botblox/UbiSwitch-DaughterBoard-Designs/UbiSwitch DaughterBoard Mini /Source Kicad Files/BOM BB-UDM-A-1.xlsx

No | Ref | Value | Description | Manufacturer | Manufacturer Part Number | LCSC | Footprint | Quantity | Supplier 1 | Cost @10pcs | Cost @100pcs
1 | C1, C2, C3, C4, C5, C6, C7, C8, C11, C12, C13, C14, C15, C16, C17, C18, | 0.1uF | CAP CER 0.1UF 50V X7R 0402 | Murata Electronics | GRM155R71H104KE14J | C85858 | Kpk:C_0402_Small | 16 | LCSC | 0.0117 | 0.0117
2 | C9, C10, C19, C20, | 1nF/2kV | CAP CER 1000PF 2KV X7R 1206 | Yageo | CC1206KKX7RDBB102 | C23631 | Capacitor_SMD:C_1206_3216Metric | 4 | LCSC | 0.015 | 0.015
3 | C21, C22, | 0.01uF/1kV | CAP CER 10000PF 1000V X7R 1206 | YAGEO | CC1206KKX7RCBB103 | C107192 | Capacitor_SMD:C_1206_3216Metric | 2 | LCSC | 0.0151 | 0.0151
4 | D5, D6, D7, D8, | LED_Dual_ACAC | LED GREEN/RED CLEAR CHIP SMD | Lite-On Inc. | LTST-C295KGKRKT | C364568 | Kpk:LED_1608_ACAC | 4 | LCSC | 0.0462 | 0.0383
5 | D11, | 12V | DIODE ZENER 12V 300MW SOD323 | ON Semiconductor | MM3Z12VT1G | C236177 | Diode_SMD:D_SOD-323 | 1 | LCSC | 0.0564 | 0.0471
6 | D12, | SMAJ54CA | TVS DIODE 54V 87.1V DO214AC | Vishay Semiconductor Diodes Division | SMAJ54CA-E3/61 | C173507 | Diode_SMD:D_SMA | 1 | LCSC | 0.0595 | 0.0469
7 | D19, | GREEN | LED PURE GREEN 1608 SMD | Lite-On | LTST-C191KGKT | C125098 | LED_SMD:LED_0603_1608Metric | 1 | LCSC | 0.0211 | 0.0211
8 | J1, J16, J18, | Conn-4P | CONN HEADER SMD R/A 4POS 1MM | Molex | 5019530407 | C587888 | Connector_Molex:Molex_Pico-Clasp_202396-0407_1x04-1MP_P1.00mm_Horizontal | 3 | Mouser | 0.645 | 0.556
9 | J4, J5, J8, J9, | Conn-8P | CONN HEADER SMD R/A 8POS 1MM | Molex | 5015680807 | C587867 | Connector_Molex:Molex_Pico-Clasp_202396-0807_1x08-1MP_P1.00mm_Horizontal | 4 | LCSC | 0.3209 | 0.261
10 | J7, J13, | ERF8-030-05.0-S-DV-K-TR | CONN SOCKET 60POS SMD GOLD | Samtec Inc. | ERF8-030-05.0-S-DV-K-TR |  | Kpk:SAMTEC_ERF8-030-05.0-S-DV-K-TR | 2 | Mouser | 7.14 | 5.26
11 | J17, | Conn-6P | CONN HEADER SMD R/A 6POS 1MM | Molex | 5015680607 | C505000 | Connector_Molex:Molex_Pico-Clasp_202396-0607_1x06-1MP_P1.00mm_Horizontal | 1 | LCSC | 0.3334 | 0.2798
12 | L1, L2, L3, L4, L5, L6, L7, L8, L9, L10, L11, L12, L13, L14, L15, L16, | CMC-800R | CMC 300MA 2LN 800OHM SMD | CND-tek | CND-WCM0805M801-2 | C3020807 | Kpk:SRF2012A-801Y | 16 | LCSC | 0.0291 | 0.0291
13 | Q1, | SI2337DS | MOSFET P-CH 80V 2.2A SOT23-3 | Vishay Intertech | SI2337DS-T1-GE3 | C83155 | Package_TO_SOT_SMD:SOT-23 | 1 | LCSC | 0.5663 | 0.5122
14 | R1, R25, | 1M | RES SMD 1M OHM 5% 1/4W 1206 | Yageo | RC1206JR-071ML | C148194 | Resistor_SMD:R_1206_3216Metric | 2 | LCSC | 0.0034 | 0.0034
15 | R4, R5, | 150R | RES 150 OHM 1% 1/16W 0402 | Yageo | RC0402FR-07150RL | C138054 | Resistor_SMD:R_0402_1005Metric | 2 | LCSC | 0.001 | 0.001
16 | R7, | DNI |  |  | DNI |  | Resistor_SMD:R_0603_1608Metric_Pad0.98x0.95mm_HandSolder | 1
17 | R8, | 56K | RES 56K OHM 1% 1/16W 0402 | Yageo | RC0402FR-0756KL | C114756 | Resistor_SMD:R_0402_1005Metric | 1 | LCSC | 0.0006 | 0.0006
18 | R9, R10, R11, R12, R13, R14, R15, R16, R17, R18, R19, R20, R21, R22, R23, R24, | 75R | RES SMD 75 OHM 1% 1/16W 0402 | Yageo | RC0402FR-0775RL | C114757 | Resistor_SMD:R_0402_1005Metric | 16 | LCSC | 0.0008 | 0.0008
19 | R75, | 1K | RES SMD 1K OHM 1% 1/16W 0402 | Yageo | RC0402FR-071KL | C106235 | Resistor_SMD:R_0402_1005Metric | 1 | LCSC | 0.0007 | 0.0007
20 | T1, T2, T3, T4, T5, T6, T7, T8, T9, T10, T11, T12, T13, T14, T15, T16, | SM453229-381N7Y | XFRMR 1:1 350UH SUPER TINY SMD | Bourns Inc. | SM453229-381N7Y | C913239 | Kpk:SM453229-381N7Y_thinner | 16 | Ickey | 0.21 | 0.21
 |  |  |  |  |  |  |  |  |  | 22.846 | 18.4182
