botblox/UbiSwitch-DaughterBoard-Designs/UbiSwitch DaughterBoard/Source Kicad Files/BOM BB-UD1-A-1.xlsx

No | Ref | Value | Description | Manufacturer | Manufacturer Part Number | LCSC | Footprint | Quantity | Supplier 1 | Cost @10pcs | Cost @100pcs
1 | C1, C2, C3, C4, C5, C6, C7, C8, C11, C12, C13, C14, C15, C16, C17, C18, C22, C23, C24, C25, C26, C27, C28, C29, C32, C33, C34, C35, C36, C37, C38, C39, C42, C59, C60, C67, C68, C75, C76, | 0.1uF | CAP CER 0.1UF 50V X7R 0402 | Murata Electronics | GRM155R71H104KE14J | C85858 | Kpk:C_0402_Small | 39 | LCSC | 0.0117 | 0.0117
2 | C9, C10, C19, C20, C30, C31, C40, C41, | 1nF/2kV | CAP CER 1000PF 2KV X7R 1206 | Yageo | CC1206KKX7RDBB102 | C23631 | Capacitor_SMD:C_1206_3216Metric | 8 | LCSC | 0.015 | 0.015
3 | C21, | 0.01uF/1kV | CAP CER 10000PF 1000V X7R 1206 | YAGEO | CC1206KKX7RCBB103 | C107192 | Capacitor_SMD:C_1206_3216Metric | 1 | LCSC | 0.0151 | 0.0151
4 | C43, C44, | 2.2u | CAP CER 2.2UF 100V X7R 1206 | Samsung Electro-Mechanics | CL31B225KCHSNNE | C170101 | Capacitor_SMD:C_1206_3216Metric | 2 | LCSC | 0.0912 | 0.0912
5 | C45, C46, C47, C48, C49, C50, | 22uF | CAP CER 22UF 16V X6S 0805 | Samsung Electro-Mechanics | CL21X226MOYNNWE | C3039691 | Capacitor_SMD:C_0805_2012Metric | 6 | LCSC | 0.0881 | 0.0727
6 | C51, | 20p | CAP CER 20PF 50V C0G/NPO 0402 | Yageo | CC0402JRNPO9BN200 | C107000 | Kpk:C_0402_Small | 1 | LCSC | 0.024 | 0.011
7 | C52, | 1000pF | CAP CER 1000PF 50V X7R 0402 | Walsin Tech Corp | 0402B102K500CT | C301925 | Kpk:C_0402_Small | 1 | LCSC | 0.002 | 0.002
8 | C56, C57, C62, C63, C64, C65, C70, C71, C72, C73, C78, C79, | 47uF | CAP CER 47UF 10V X5R 0805 | TDK | C2012X5R1A476MTJ00E | C76636 | Capacitor_SMD:C_0805_2012Metric | 12 | LCSC | 0.1599 | 0.1599
9 | C58, C61, C66, C69, C74, C77, | 1uF | CAP CER 1UF 10V X6S 0402 | Murata Electronics | GRM155C81A105KA12D | C162161 | Kpk:C_0402_Small | 6 | LCSC | 0.0183 | 0.0183
10 | D1, D2, D3, D4, D5, D6, D7, D8, D9, D10, | LED_Dual_ACAC | LED GREEN/RED CLEAR CHIP SMD | Lite-On Inc. | LTST-C295KGKRKT | C364568 | Kpk:LED_1608_ACAC | 10 | LCSC | 0.0462 | 0.0383
11 | D11, | 12V | DIODE ZENER 12V 300MW SOD323 | ON Semiconductor | MM3Z12VT1G | C236177 | Diode_SMD:D_SOD-323 | 1 | LCSC | 0.0564 | 0.0471
12 | D12, | SMAJ54CA | TVS DIODE 54V 87.1V DO214AC | Vishay Semiconductor Diodes Division | SMAJ54CA-E3/61 | C173507 | Diode_SMD:D_SMA | 1 | LCSC | 0.0595 | 0.0469
13 | D13, | 4.7V | DIODE ZENER 4.7V 550MW SOD323F | Nexperia | BZX84J-C4V7,115 | C551023 | Kpk:D_SOD-323F | 1 | LCSC | 0.221 | 0.117
14 | D14, D16, D17, D18, D19, | GREEN | LED PURE GREEN 1608 SMD | Lite-On | LTST-C191KGKT | C125098 | LED_SMD:LED_0603_1608Metric | 5 | LCSC | 0.0211 | 0.0211
15 | D15, | 100V 60A pk | DIODE SCHOTTKY 100V 1.7A DO214AC | Vishay General Semiconductor | VSSA310S-E3/61T | C468173 | Diode_SMD:D_SMA | 1 | Mouser | 0.381 | 0.26
16 | J1, J16, J18, | Conn-4P | CONN HEADER SMD 4POS 1MM | Molex | 5013310407 | C505339 | Kpk:Molex_Pico-Clasp_501331-0407_1x04-1MP_P1.00mm_Vertical_PicoBlade_Alternate | 3 | LCSC | 0.3077 | 0.2502
17 | J2, J6, J10, | SFP+ | CONN SFP+ RCPT 20POS SLD R/A SMD | Molex | 744410001 | C277615 | Kpk:Connector_SFP | 3 | LCSC | 0.5378 | 0.3771
18 | J3, | Conn_Coaxial | CONN UMC RCPT STR 50 OHM SMD | TE Connectivity AMP Connectors | 1909763-1 | C392444 | Connector_Coaxial:U.FL_Hirose_U.FL-R-SMT-1_Vertical | 1 | LCSC | 0.2335 | 0.1854
19 | J4, J5, J8, J9, J11, J12, J14, J15, | Conn-8P | CONN HEADER SMD 8POS 1MM | Molex | 5013310807 | C505340 | Kpk:Molex_Pico-Clasp_501331-0807_1x08-1MP_P1.00mm_Vertical_PicoBlade_Alternate | 8 | Digi-Key | 0.727 | 0.606
20 | J7, J13, | ERF8-030-05.0-S-DV-K-TR | CONN SOCKET 60POS SMD GOLD | Samtec Inc. | ERF8-030-05.0-S-DV-K-TR |  | Kpk:SAMTEC_ERF8-030-05.0-S-DV-K-TR | 2 | Mouser | 7.14 | 5.26
21 | J17, | Conn-9P | CONN HEADER SMD 9POS 1MM | Molex | 5013310907 | C114116 | Kpk:Molex_Pico-Clasp_501331-0907_1x09-1MP_P1.00mm_Vertical_PicoBlade_Alternate | 1 | LCSC | 0.2843 | 0.2261
22 | L1, L2, L3, L4, L5, L6, L7, L8, L9, L10, L11, L12, L13, L14, L15, L16, L17, L18, L19, L20, L21, L22, L23, L24, L25, L26, L27, L28, L29, L30, L31, L32, | CMC-800R | CMC 300MA 2LN 800OHM SMD | CND-tek | CND-WCM0805M801-2 | C3020807 | Kpk:SRF2012A-801Y | 32 | LCSC | 0.0291 | 0.0291
23 | L33, | 10uH 4A | FIXED IND 10UH 4A 68MOHM SMD | AVX Corporation | LMLP07A7M100DTAS |  | Kpk:L_7.3x6.6_H3 | 1 | Mouser | 0.335 | 0.281
24 | L34, L35, L36, L37, L38, L39, | 3.3uH | FIXED IND 3.3UH 1.8A 135MOHM SMD | Murata Electronics | DFE252012F-3R3M=P2 | C2041573 | Inductor_SMD:L_1008_2520Metric | 6 | LCSC | 0.1158 | 0.0942
25 | N1, | SFP+_CAGE | 1X3 ZSFP+ CAGE EON W/O BELLY GAS | CZT | 10731013W008 |  | Kpk:Connector_SFP_and_Cage_10731013W008_CZT | 1 | Alibaba | 2 | 1.55
26 | Q1, | RD3P130SPTL1 | MOSFET P-CH 100V 13A TO252 | Rohm Semiconductor | RD3P130SPTL1 | C509778 | Kpk:RD3P130SPTL1 | 1 | LCSC | 1.4535 | 1.0243
27 | R1, R2, R3, R4, R5, | 150R | RES 150 OHM 1% 1/16W 0402 | Yageo | RC0402FR-07150RL | C138054 | Resistor_SMD:R_0402_1005Metric | 5 | LCSC | 0.001 | 0.001
28 | R6, R43, R49, R74, R75, | 1K | RES SMD 1K OHM 1% 1/16W 0402 | Yageo | RC0402FR-071KL | C106235 | Resistor_SMD:R_0402_1005Metric | 5 | LCSC | 0.0007 | 0.0007
29 | R7, | DNI |  |  | DNI |  | Resistor_SMD:R_0805_2012Metric_Pad1.20x1.40mm_HandSolder | 1
30 | R8, | 56K | RES 56K OHM 1% 1/16W 0402 | Yageo | RC0402FR-0756KL | C114756 | Resistor_SMD:R_0402_1005Metric | 1 | LCSC | 0.0006 | 0.0006
31 | R9, R10, R11, R12, R13, R14, R15, R16, R17, R18, R19, R20, R21, R22, R23, R24, R26, R27, R28, R29, R30, R31, R32, R33, R34, R35, R36, R37, R38, R39, R40, R41, | 75R | RES SMD 75 OHM 1% 1/16W 0402 | Yageo | RC0402FR-0775RL | C114757 | Resistor_SMD:R_0402_1005Metric | 32 | LCSC | 0.0008 | 0.0008
32 | R25, | 1M | RES SMD 1M OHM 5% 1/4W 1206 | Yageo | RC1206JR-071ML | C148194 | Resistor_SMD:R_1206_3216Metric | 1 | LCSC | 0.0034 | 0.0034
33 | R42, | 220K | RES SMD 220K OHM 1% 1/16W 0402 | Yageo | RC0402FR-07220KL | C138030 | Resistor_SMD:R_0402_1005Metric | 1 | LCSC | 0.0014 | 0.0014
34 | R44, | 31.6K | RES 31.6K OHM 1% 1/16W 0402 | Yageo | RC0402FR-0731K6L | C276265 | Resistor_SMD:R_0402_1005Metric | 1 | LCSC | 0.0007 | 0.0007
35 | R45, | 23.7k | RES SMD 23.7K OHM 1% 1/16W 0402 | Yageo | RC0402FR-0723K7L | C327362 | Resistor_SMD:R_0402_1005Metric | 1 | LCSC | 0.017 | 0.006
36 | R46, | 86.6K | RES SMD 86.6K OHM 1% 1/16W 0402 | Yageo | RC0402FR-0786K6L | C477807 | Resistor_SMD:R_0402_1005Metric | 1 | LCSC | 0.0015 | 0.0015
37 | R47, | 162k | RES SMD 162K OHM 1% 1/16W 0402 | Yageo | RC0402FR-07162KL | C185462 | Resistor_SMD:R_0402_1005Metric | 1 | LCSC | 0.017 | 0.006
38 | R48, | 10K | RES SMD 10K OHM 1% 1/16W 0402 | Yageo | RC0402FR-0710KL | C60490 | Resistor_SMD:R_0402_1005Metric | 1 | LCSC | 0.0006 | 0.0006
39 | R50, R51, R52, R53, R54, R57, R58, R59, R60, R61, R62, R65, R66, R67, R68, R69, R70, R73, | 4.99K | RES 4.99K OHM 1% 1/16W 0402 | Yageo | RC0402FR-074K99L | C137965 | Resistor_SMD:R_0402_1005Metric | 18 | LCSC | 0.0007 | 0.0007
40 | R55, R63, R71, | 100R | RES 100 OHM 1% 1/16W 0402 | Yageo | RC0402FR-07100RL | C106232 | Resistor_SMD:R_0402_1005Metric | 3 | LCSC | 0.0007 | 0.0007
41 | R56, R64, R72, | 1K_DNI |  |  | DNI |  | Resistor_SMD:R_0402_1005Metric | 3
42 | T1, T2, T3, T4, T5, T6, T7, T8, T9, T10, T11, T12, T13, T14, T15, T16, T17, T18, T19, T20, T21, T22, T23, T24, T25, T26, T27, T28, T29, T30, T31, T32, | SM453229-381N7Y | XFRMR 1:1 350UH SUPER TINY SMD | Bourns Inc. | SM453229-381N7Y | C913239 | Kpk:SM453229-381N7Y_thinner | 32 | Ickey | 0.21 | 0.21
43 | U1, | TPS54360B | IC REG BCK SPLIT RAIL ADJ 8SOPWR | Texas Instruments | TPS54360BDDAR | C524806 | Package_SO:TI_SO-PowerPAD-8_ThermalVias | 1 | Texas Instruments | 1.5655 | 1.2823
