botblox/UbiSwitch-DaughterBoard-Designs/UbiSwitch DaughterBoard/Schematic UbiSwitch DaugterBoard.pdf

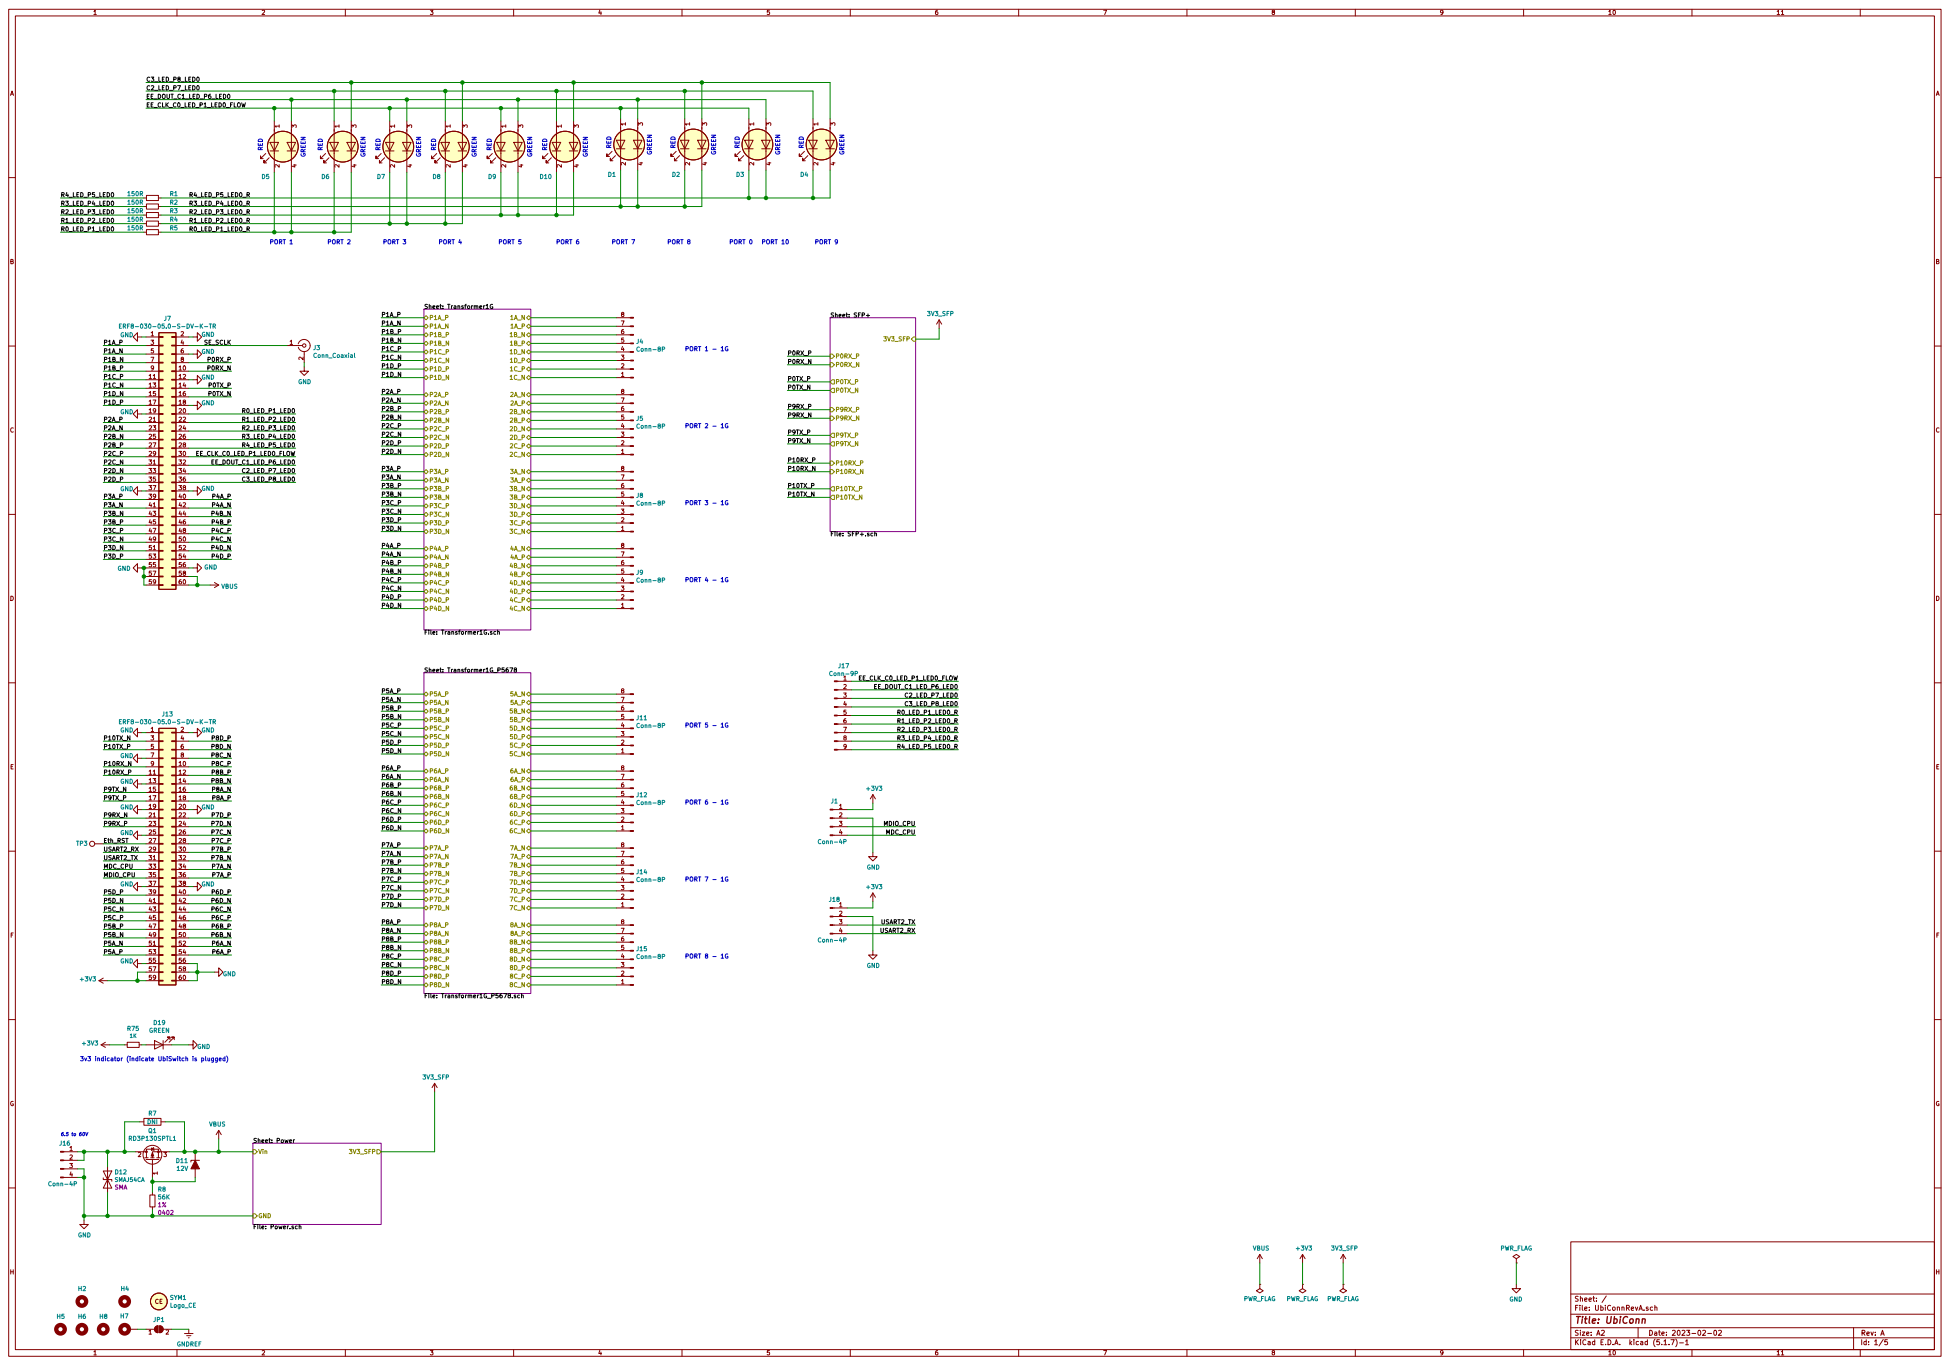
[picture p1: page 1]

3V3_SFP
Sheet: SFP+ File: SFP+.sch

3v3 indicator (indicate UbiSwitch is plugged)

File: UbiConnRevA.sch Sheet: / Sheet: Power File: Power.sch Vin GND

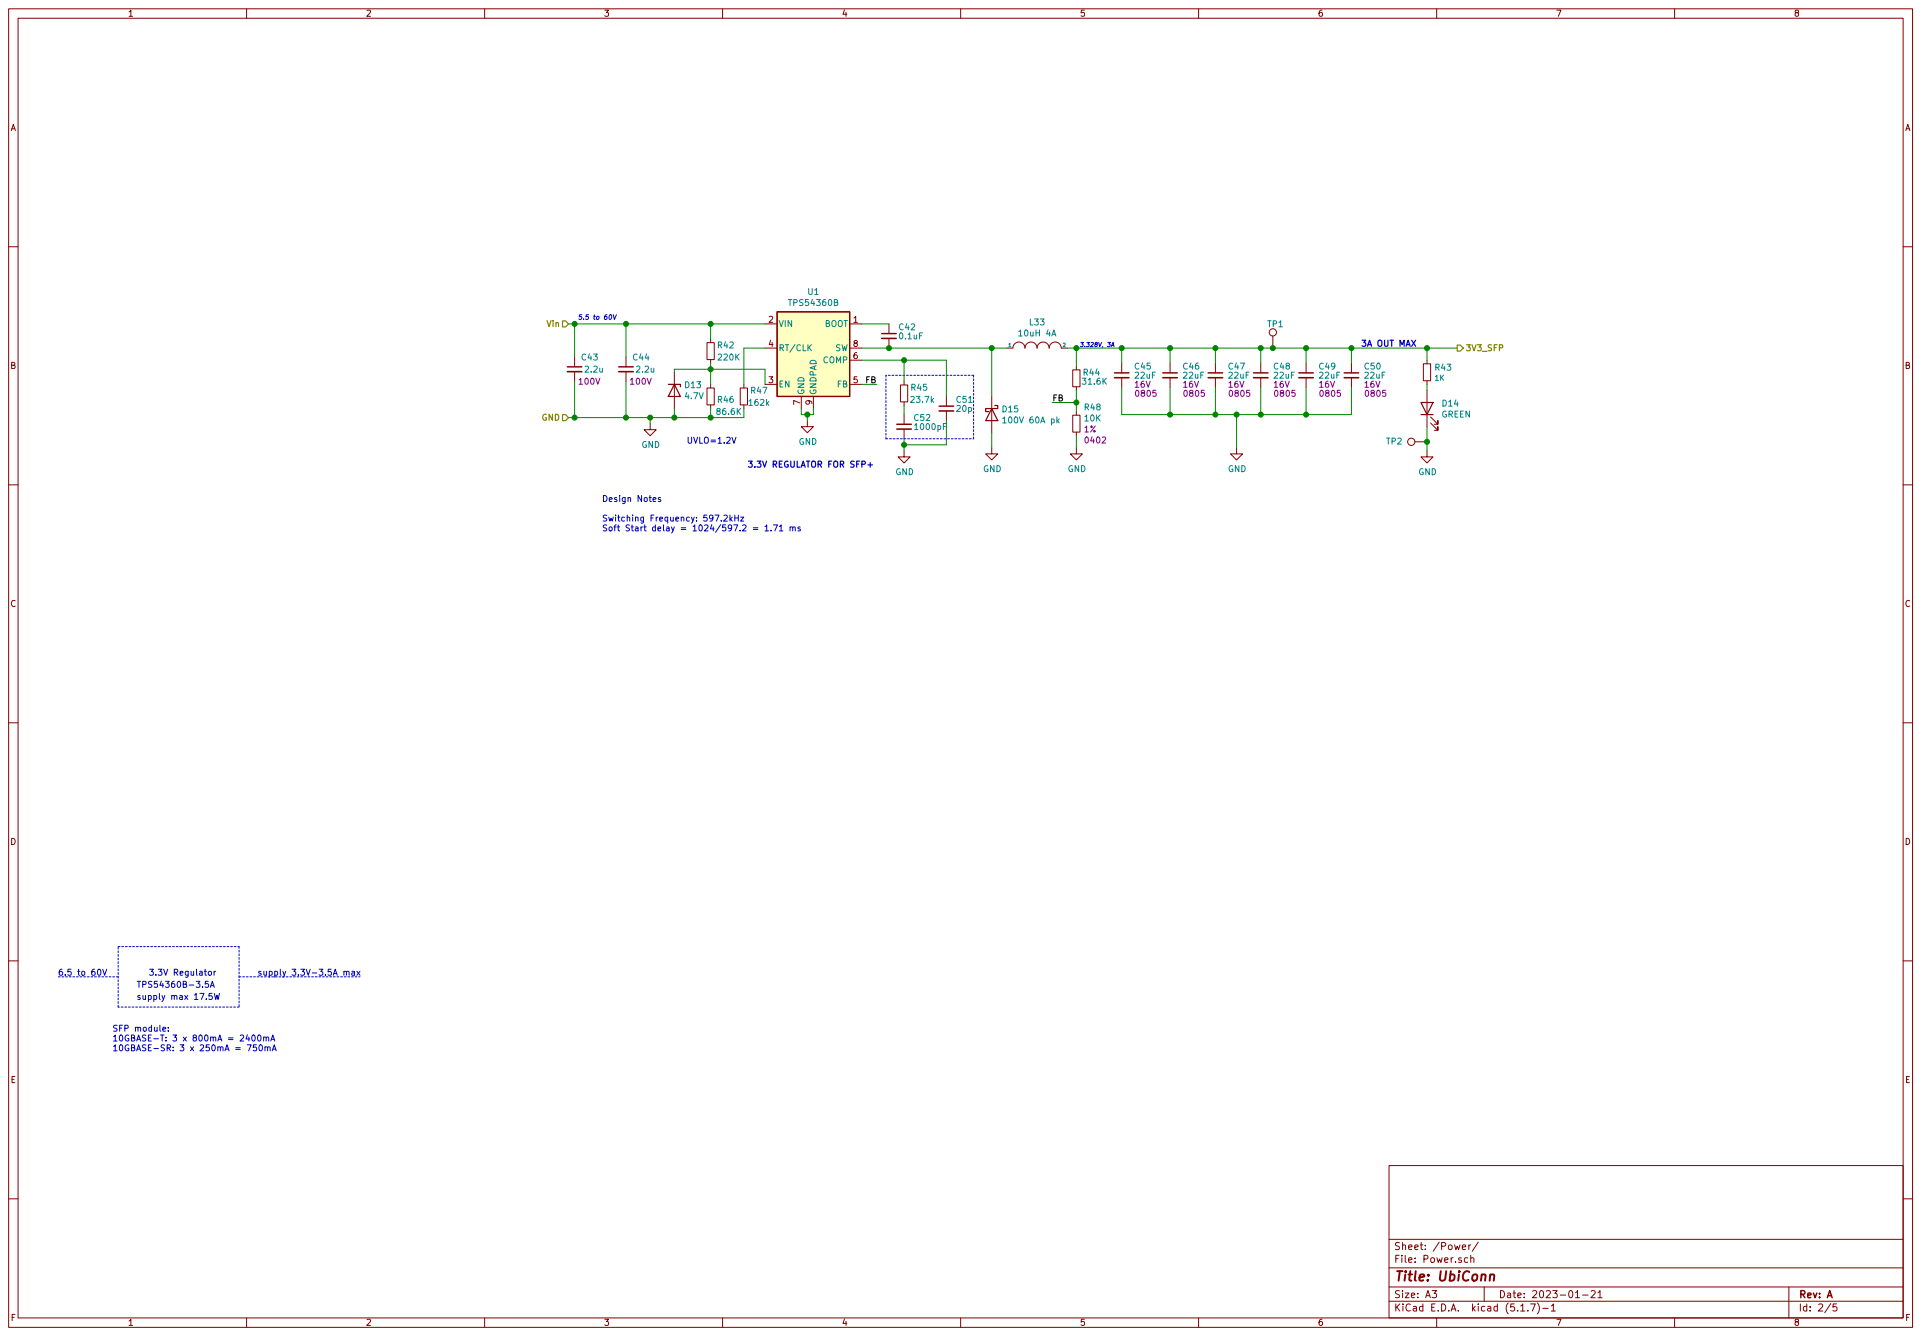
[picture p2: page 2]

Soft Start delay = 1024/597.2 = 1.71 ms UVLO=1.2V

File: Power.sch Sheet: /Power/
Id: 2/5 Title: UbiConn

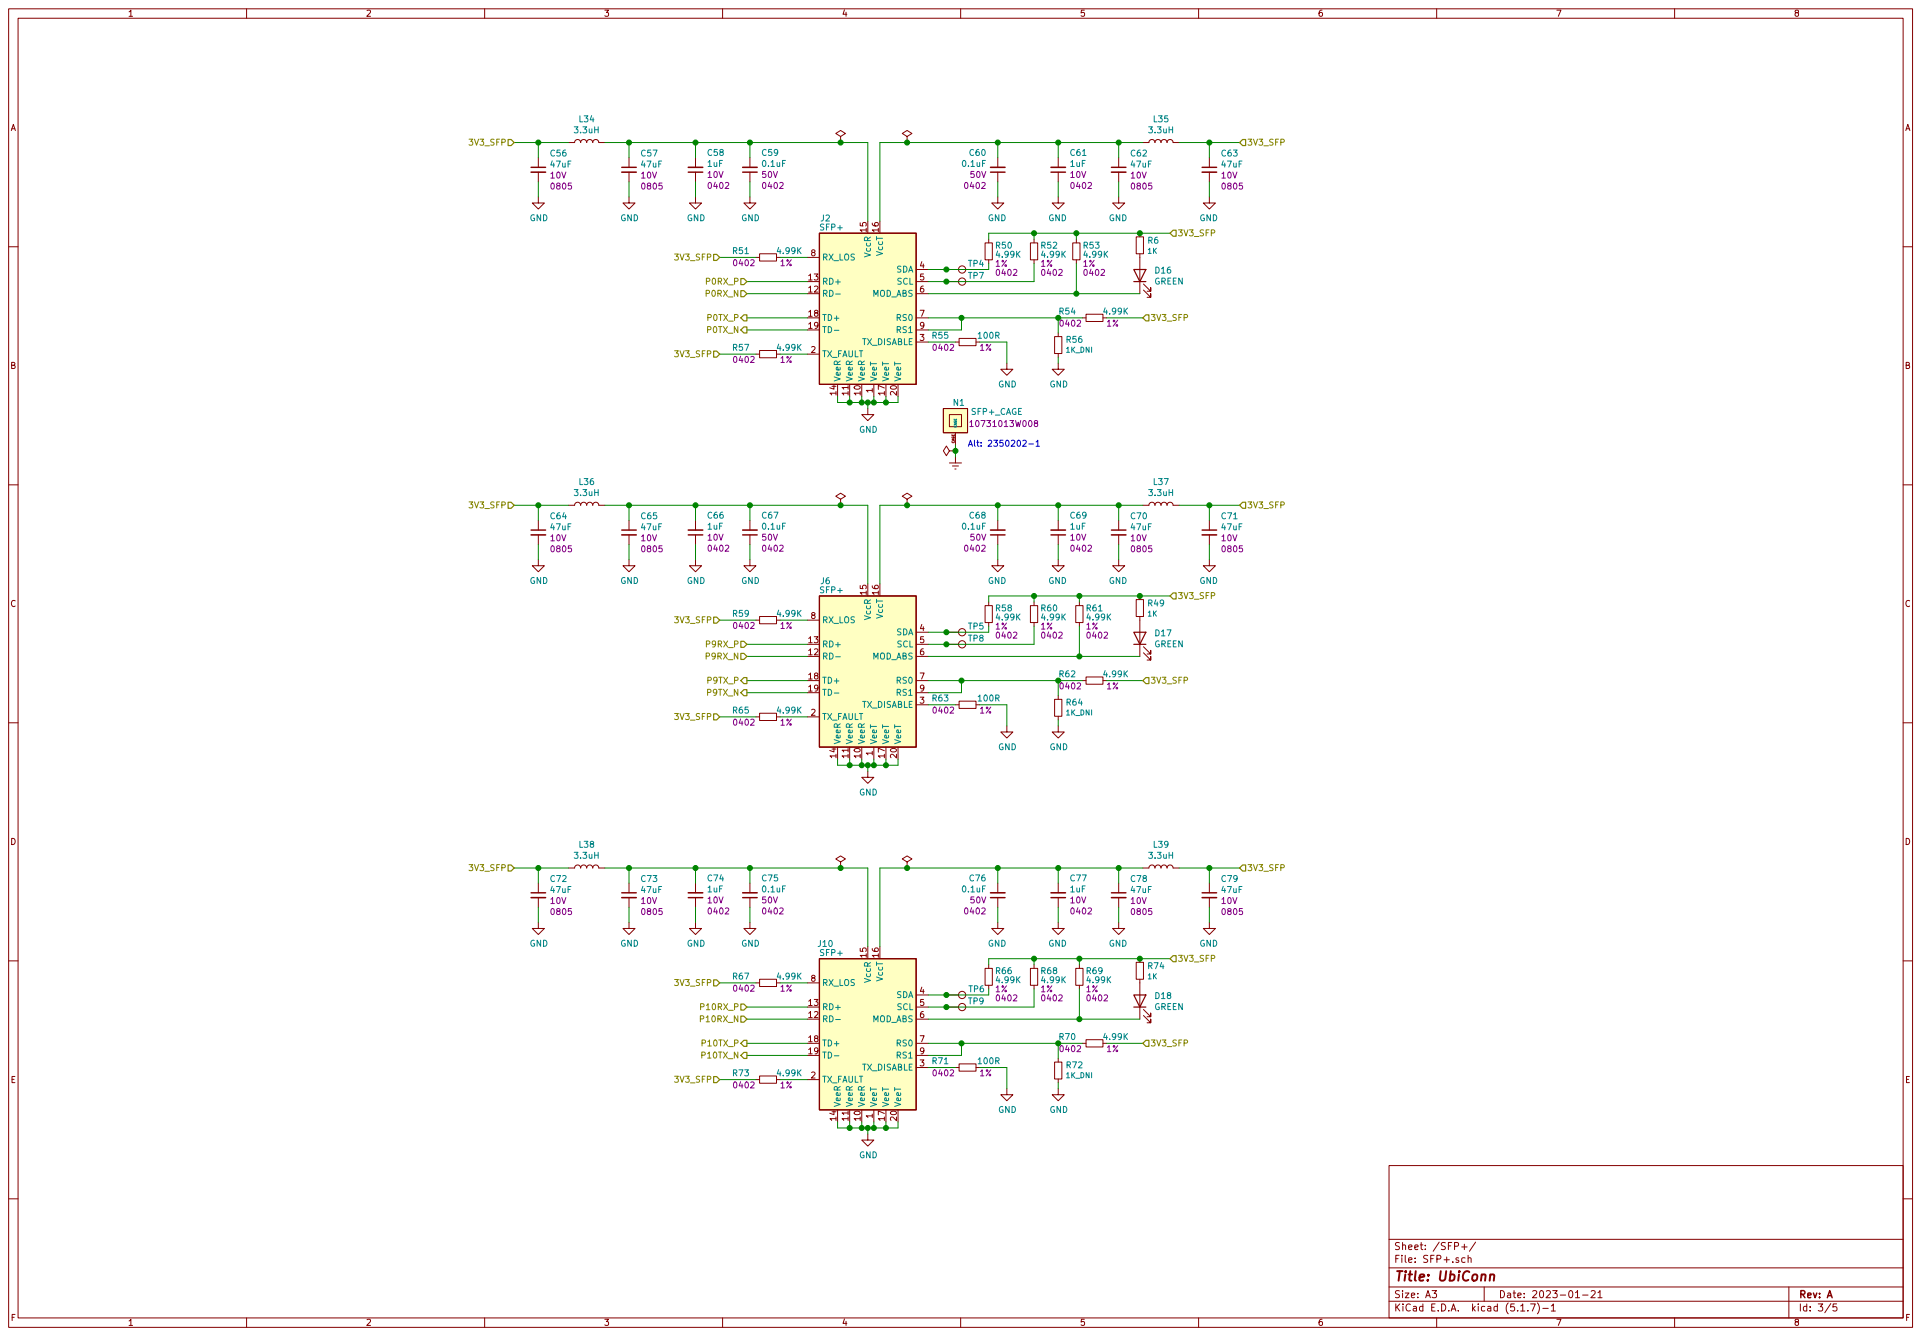
[picture p3: page 3]

File: SFP+.sch Sheet: /SFP+/
Id: 3/5 Title: UbiConn

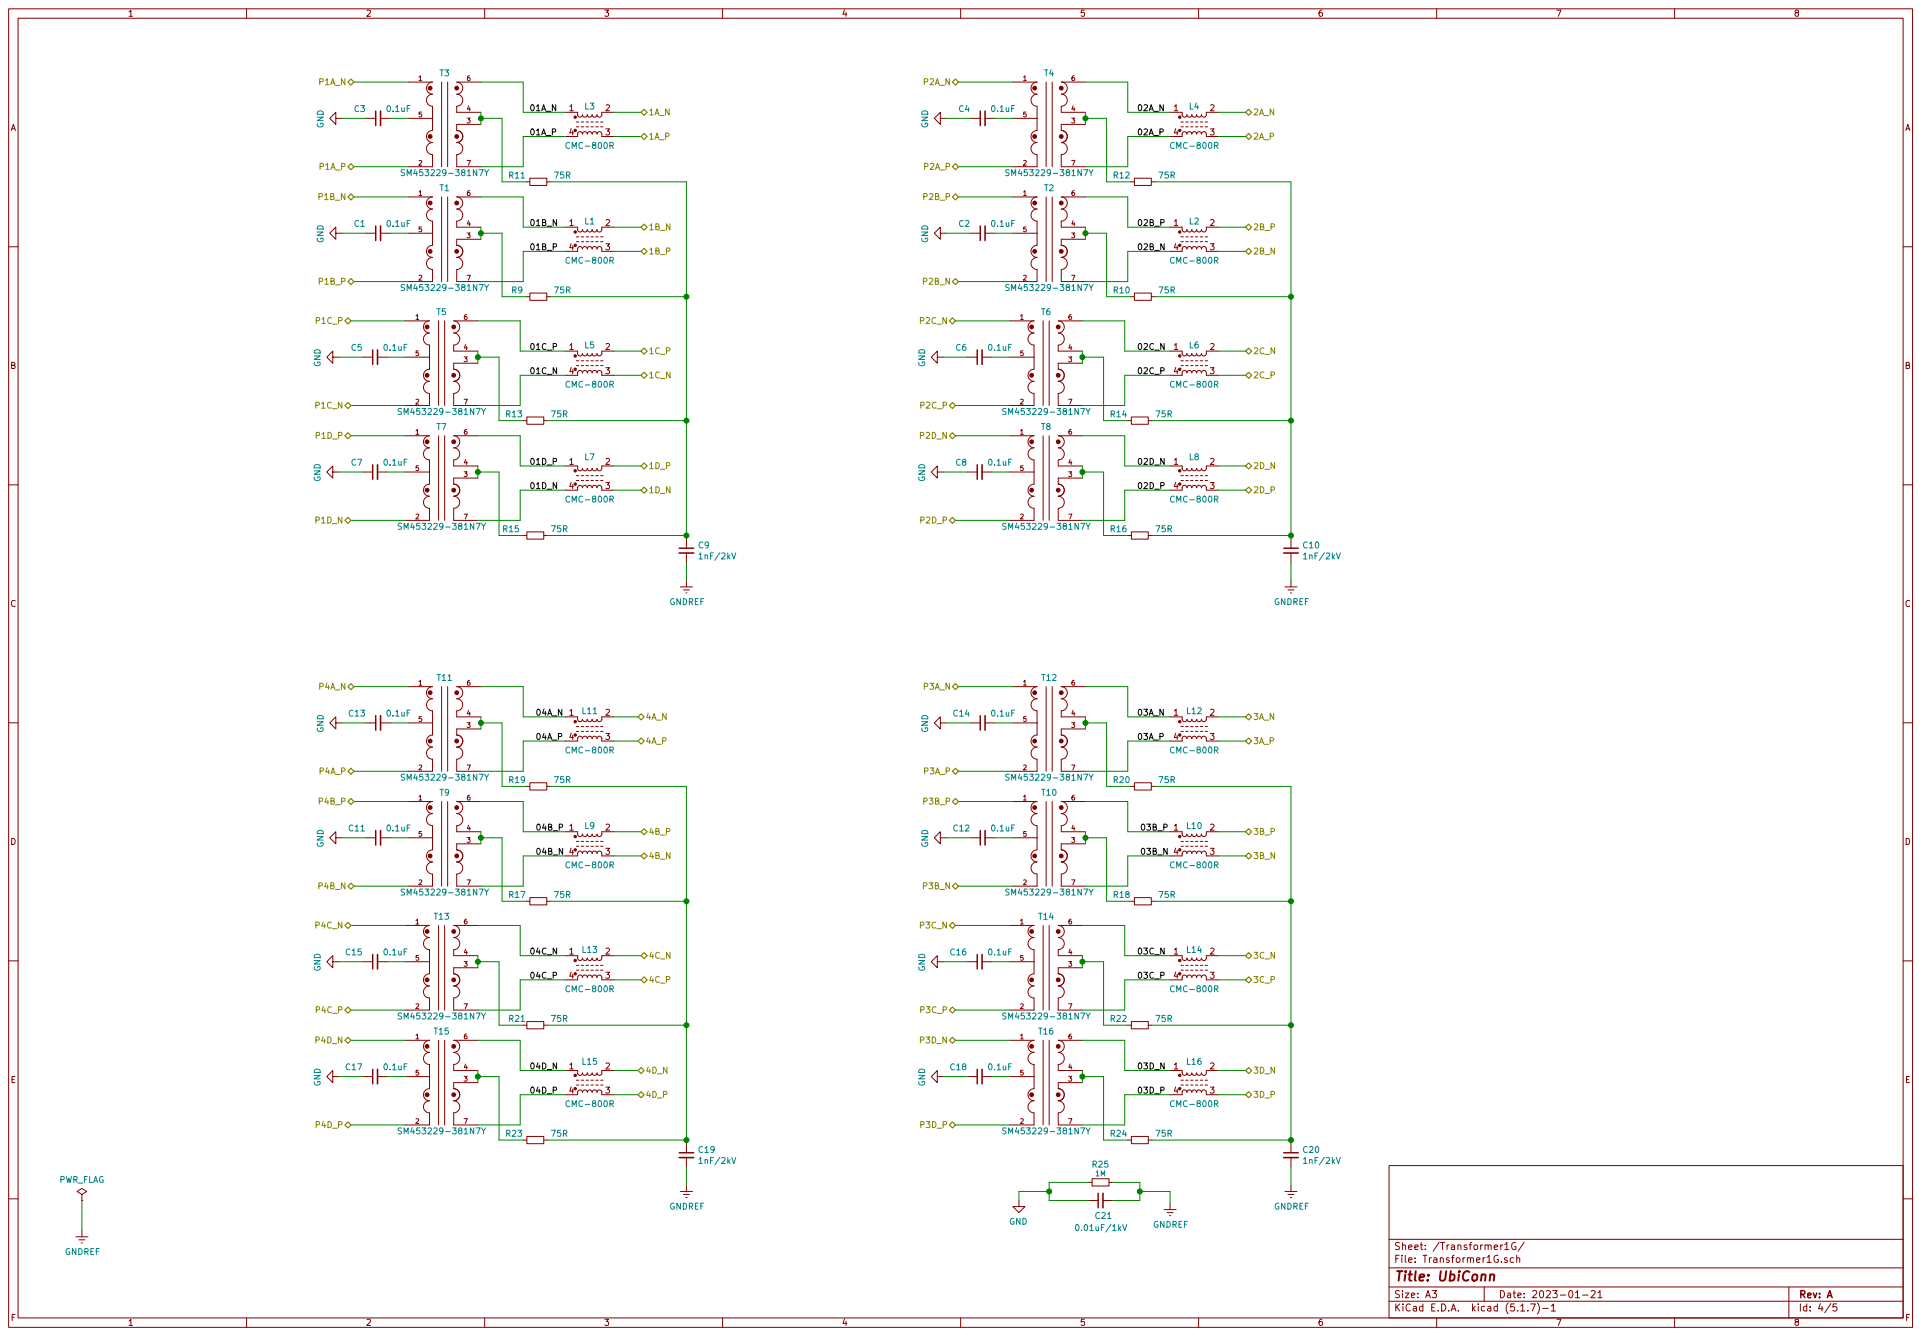
[picture p4: page 4]

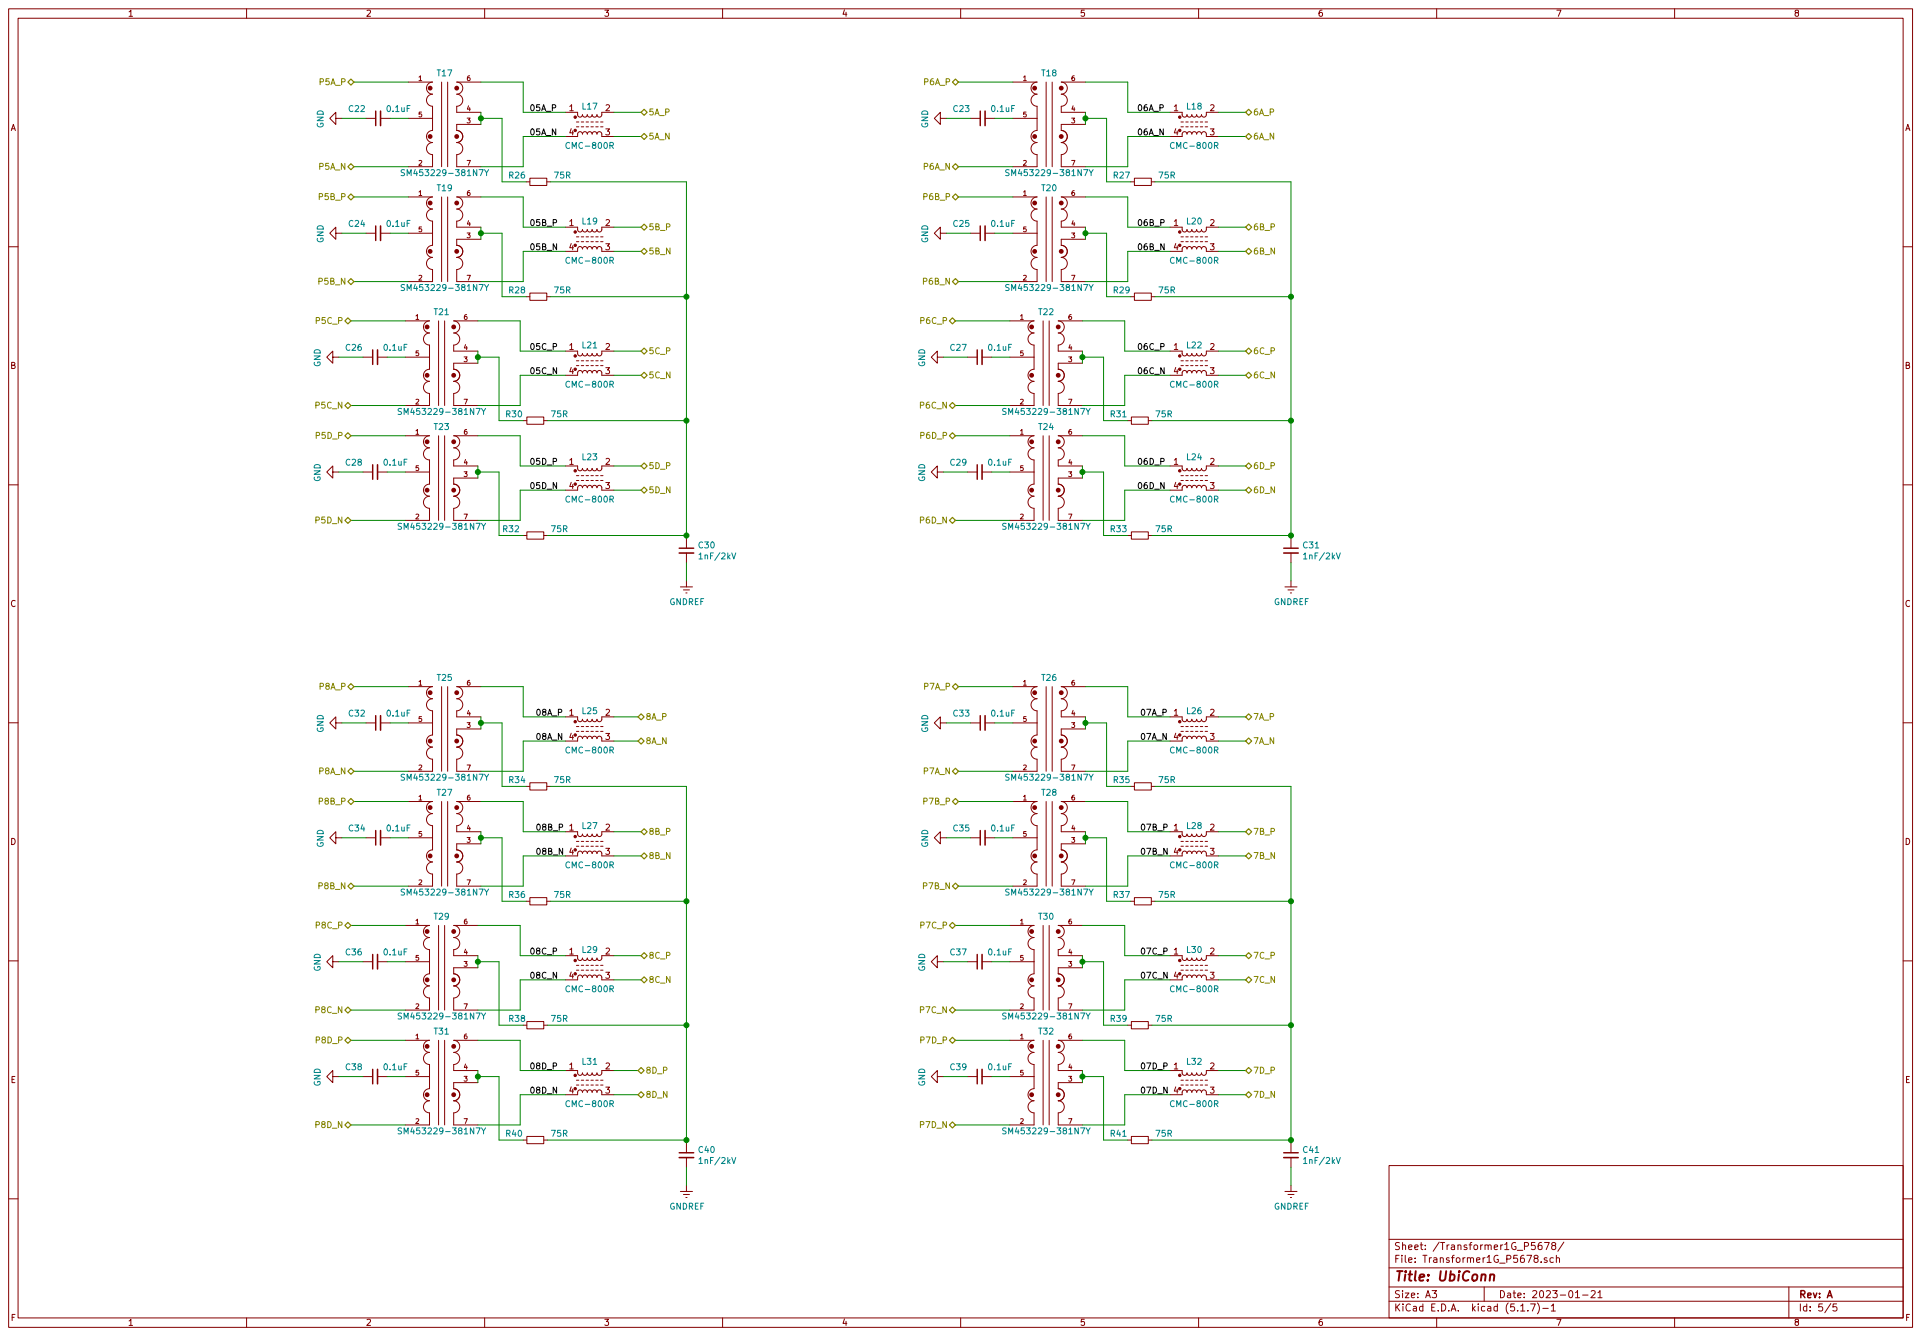
[picture p5: page 5]

L32 CMC-800R GND GND GND GND
