botblox/UbiSwitch-DaughterBoard-Designs/UbiSwitch DaughterBoard Mini /BB-UDM-A-1 Schematic.pdf

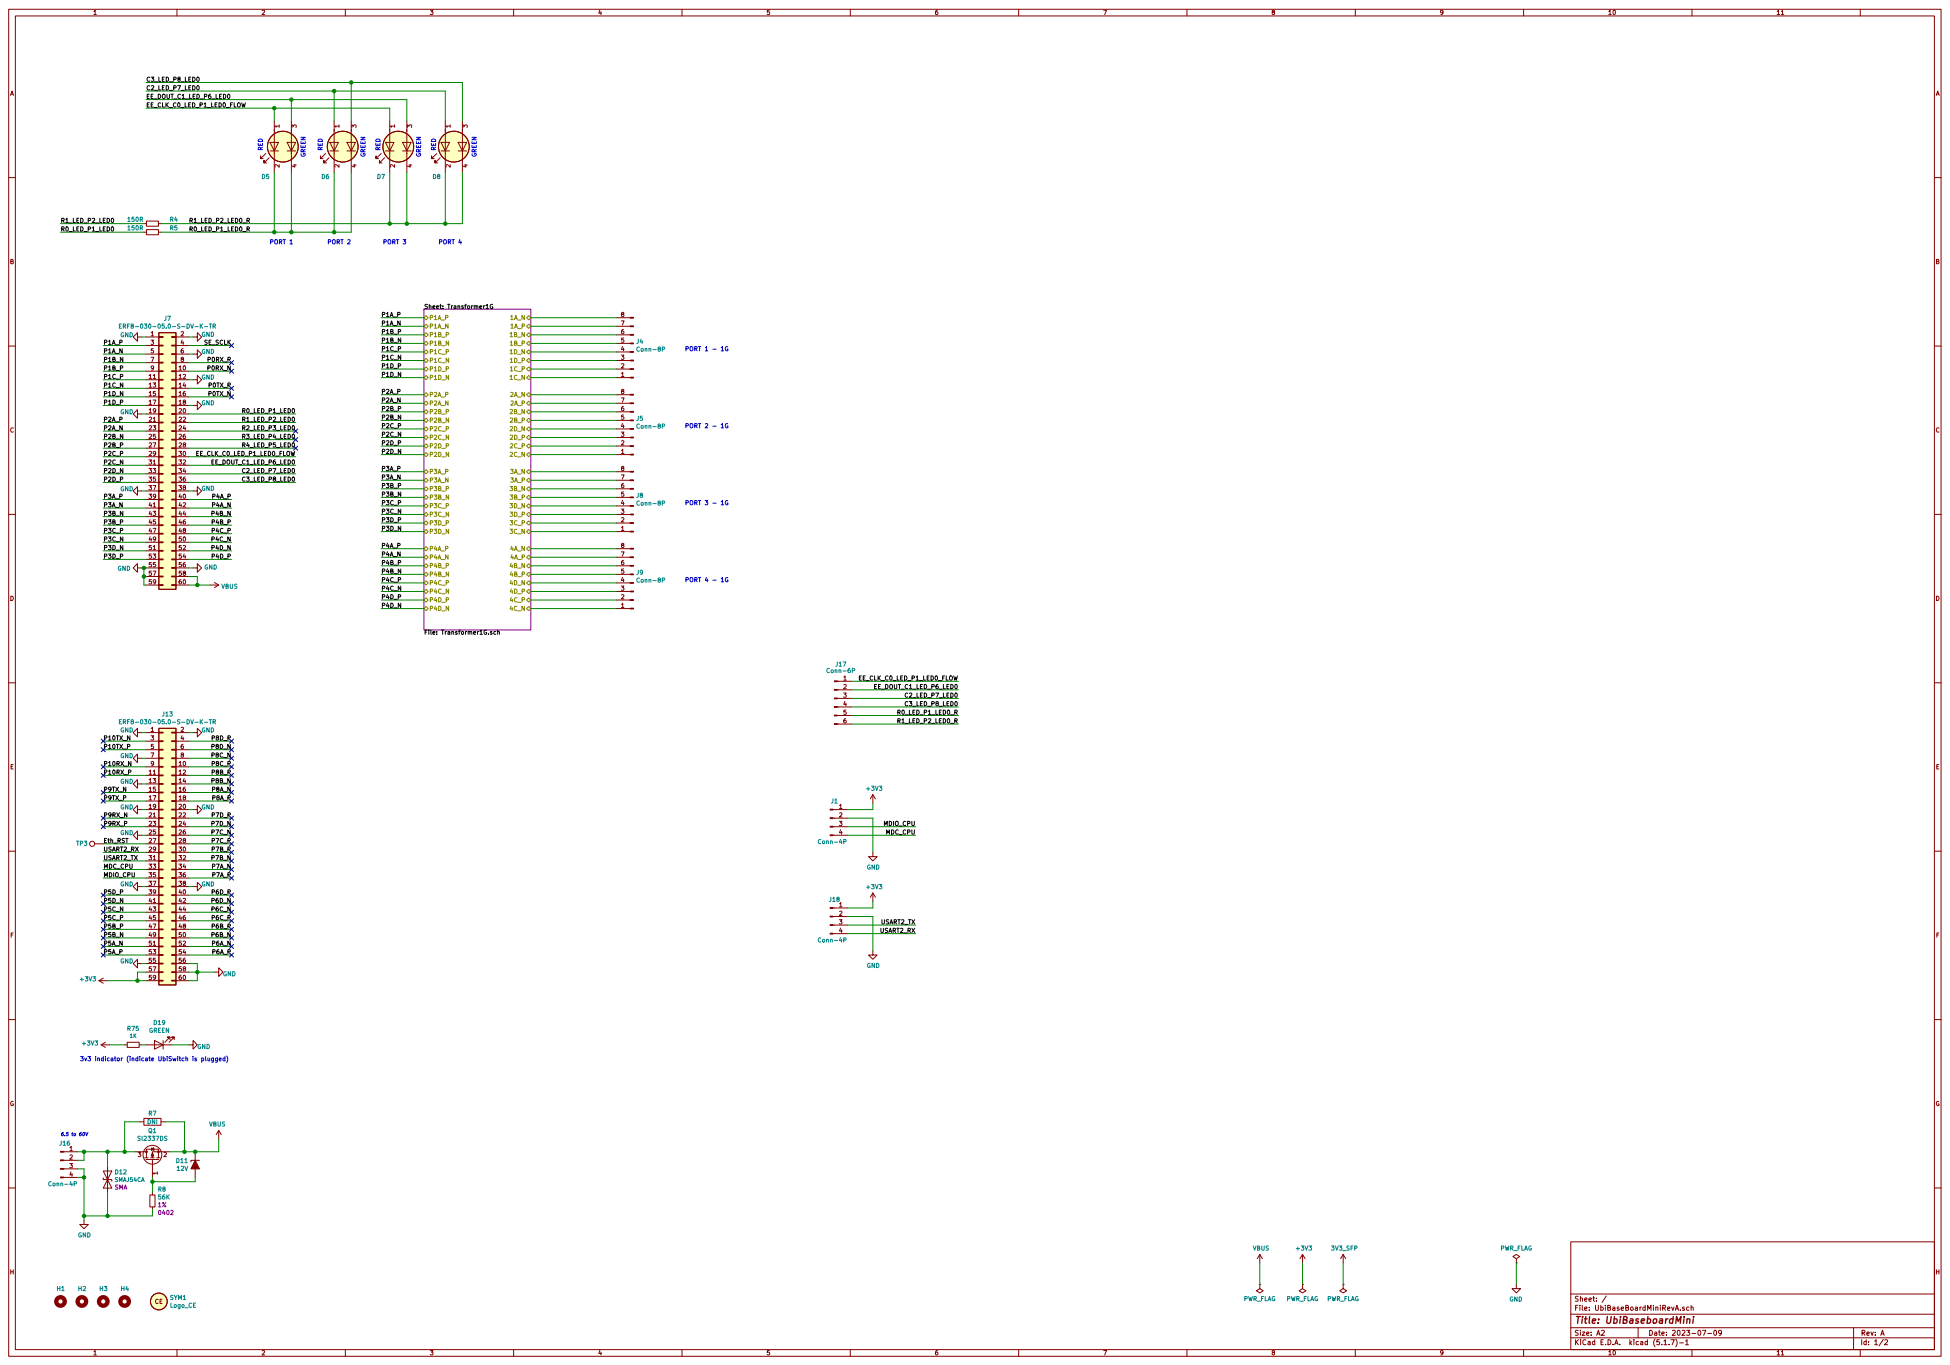
[picture p6: page 1]

3v3 indicator (indicate UbiSwitch is plugged)

Id: 1/2 Title: UbiBaseboardMini File: UbiBaseBoardMiniRevA.sch Sheet: /

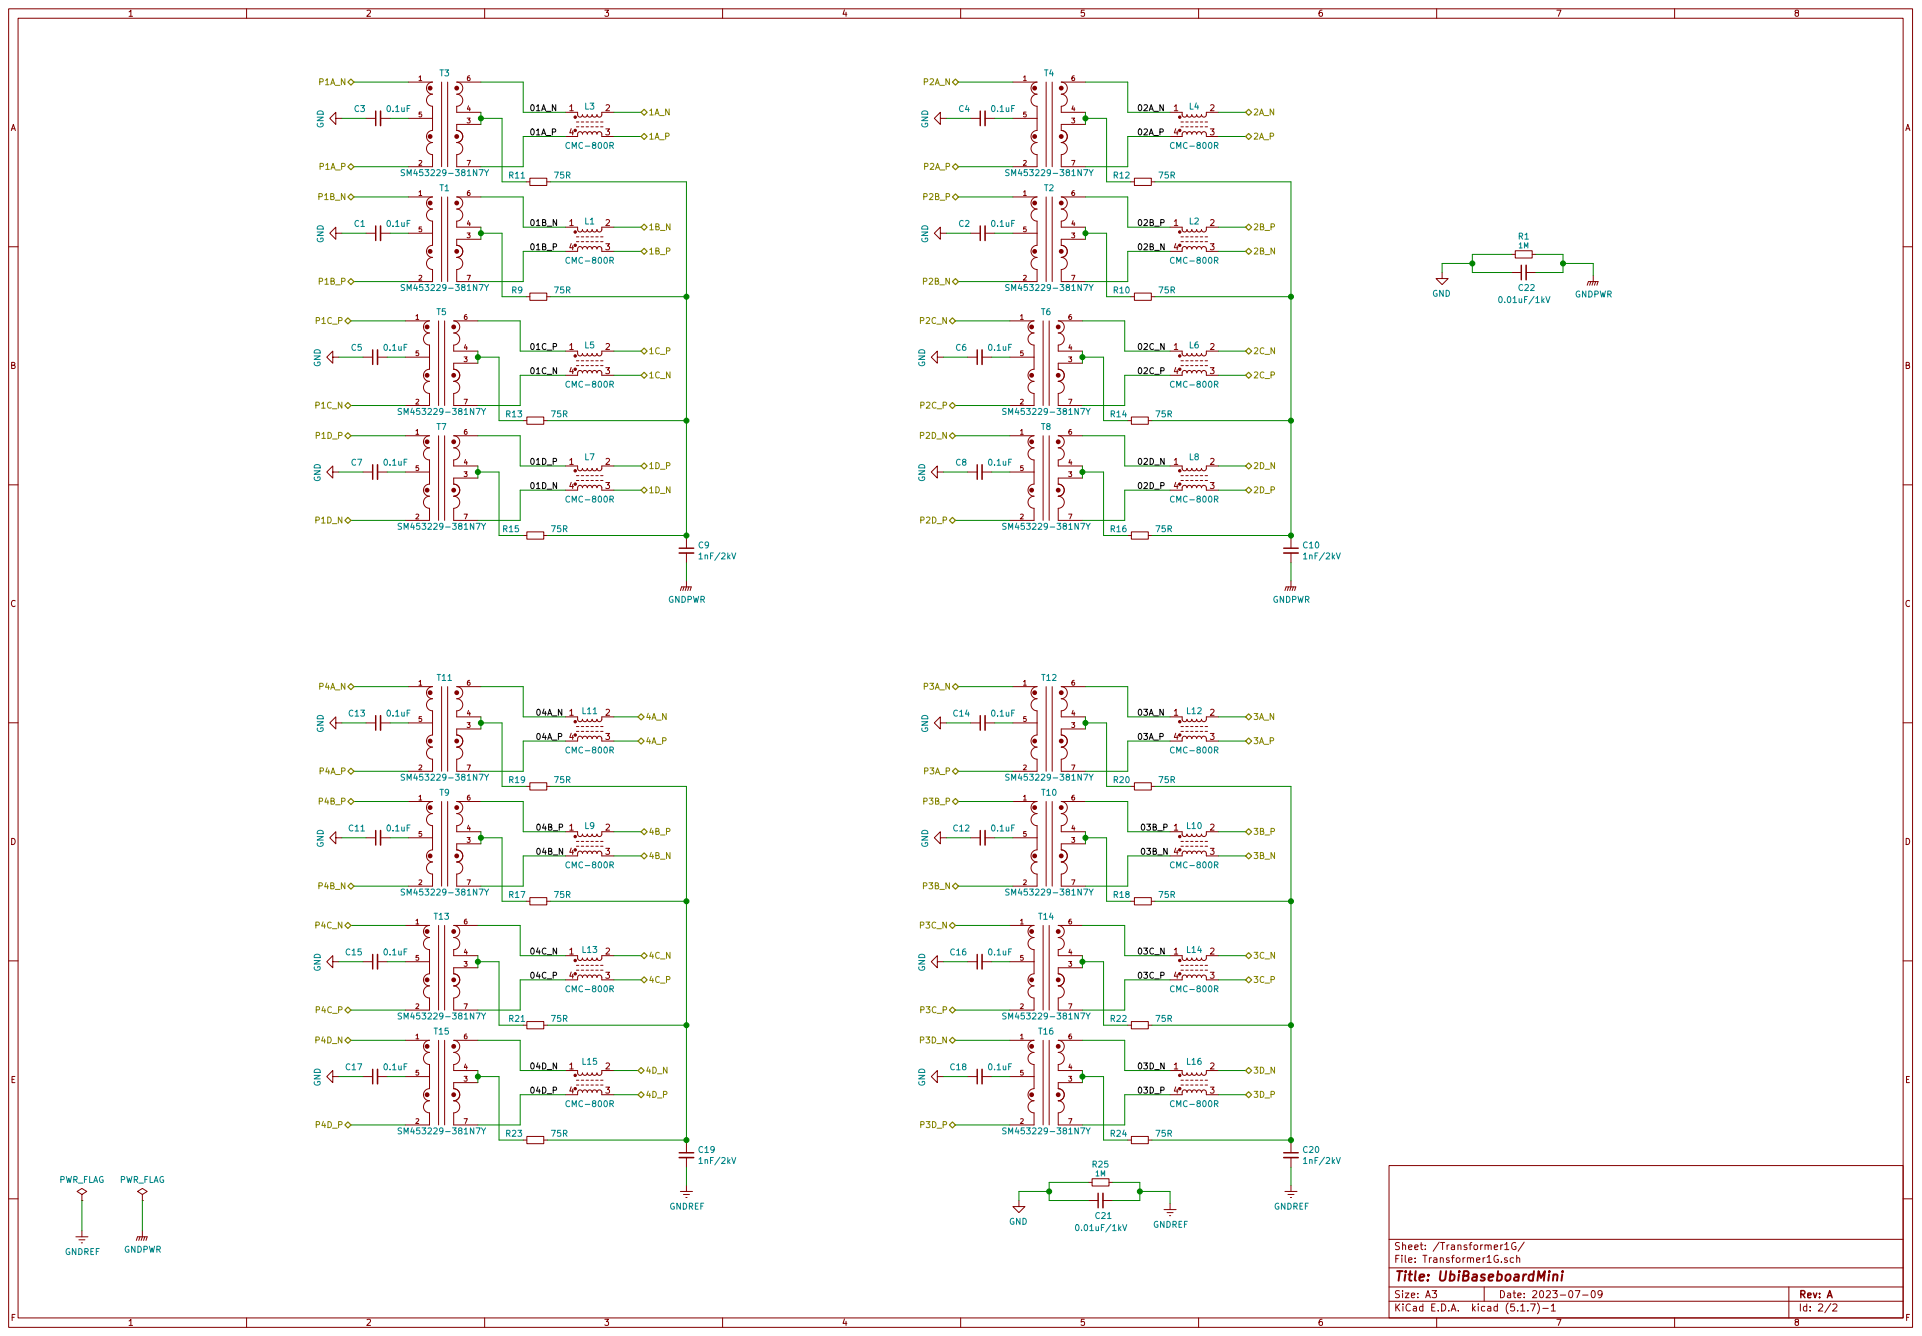
[picture p7: page 2]
