botblox/UbiSwitch-DaughterBoard-Designs/UbiSwitch DaughterBoard Mini /Source Kicad Files/UbiBaseBoardMiniRevA.kicad_pcb

## KiCad design UbiSwitch DaughterBoard Mini /Source Kicad Files/UbiBaseBoardMiniRevA.kicad_pcb (2023-10-01)

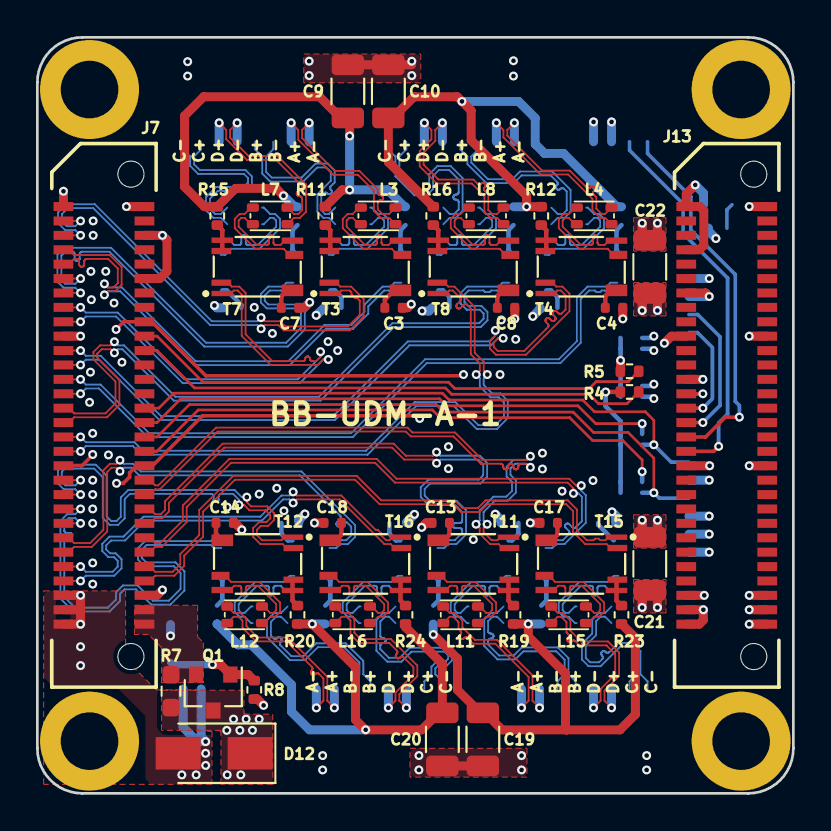
[picture p8: board UbiBaseBoardMiniRevA.kicad_pcb from above]

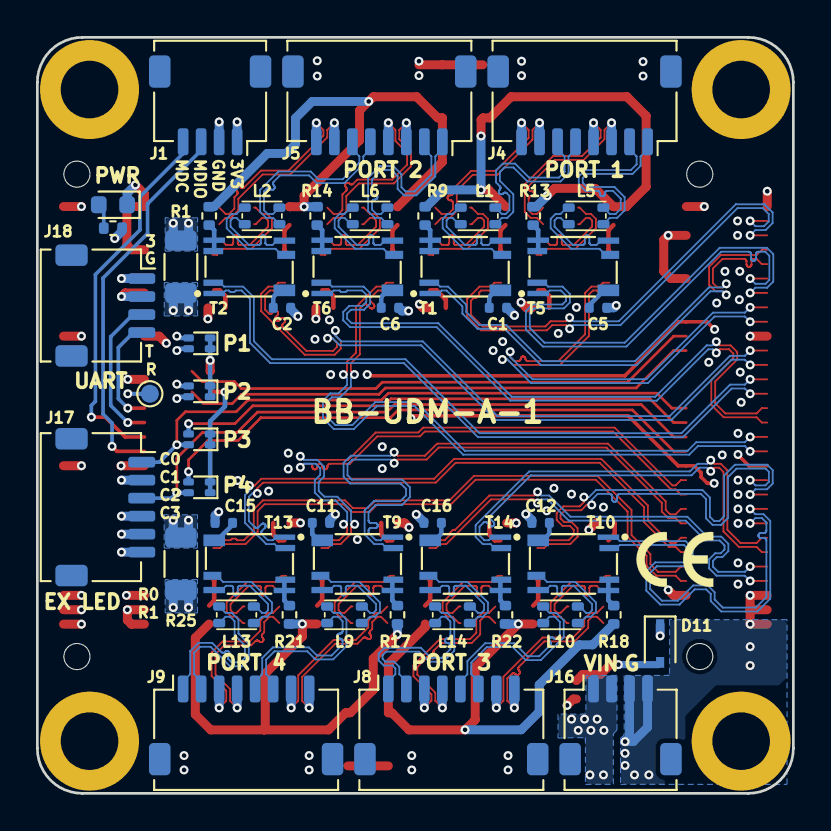
[picture p9: board UbiBaseBoardMiniRevA.kicad_pcb from below]

Board: 4 copper layers, 42.0 x 42.0 mm, 101 parts (51 on the bottom side), 153 nets.

Parts:
C1, C2, C3, C4, C5, C6, C7, C8, C11, C12, C13, C14, C15, C16, C17, C18: 0.1uF; C_0402_Small
C9, C10, C19, C20: 1nF/2kV; C_1206_3216Metric
C21, C22: 0.01uF/1kV; C_1206_3216Metric
D5, D6, D7, D8: LED_Dual_ACAC; LED_1608_ACAC
D11: 12V; D_SOD-323
D12: SMAJ54CA; D_SMA
D19: GREEN; LED_0603_1608Metric
H1, H2, H3, H4: MountingHole; MountingHole_3.2mm_M3_ISO14580_Pad
J1, J16, J18: Conn-4P; Molex_Pico-Clasp_202396-0407_1x04-1MP_P1.00mm_Horizontal
J4, J5, J8, J9: Conn-8P; Molex_Pico-Clasp_202396-0807_1x08-1MP_P1.00mm_Horizontal
J7, J13: ERF8-030-05.0-S-DV-K-TR; SAMTEC_ERF8-030-05.0-S-DV-K-TR
J17: Conn-6P; Molex_Pico-Clasp_202396-0607_1x06-1MP_P1.00mm_Horizontal
L1, L2, L3, L4, L5, L6, L7, L8, L9, L10, L11, L12, L13, L14, L15, L16: CMC-800R; SRF2012A-801Y
Q1: SI2337DS; SOT-23
R1, R25: 1M; R_1206_3216Metric
R4, R5: 150R; R_0402_1005Metric
R7: DNI; R_0603_1608Metric_Pad0.98x0.95mm_HandSolder
R8: 56K; R_0402_1005Metric
R9, R10, R11, R12, R13, R14, R15, R16, R17, R18, R19, R20, R21, R22, R23, R24: 75R; R_0402_1005Metric
R75: 1K; R_0402_1005Metric
SYM1: Logo_CE; CE-Logo_4.3x3.1mm_SilkScreen
T1, T2, T3, T4, T5, T6, T7, T8, T9, T10, T11, T12, T13, T14, T15, T16: SM453229-381N7Y; SM453229-381N7Y_thinner
TP3: TestPoint; TestPoint_Pad_D1.0mm

Connections:
+3V3: J1.1, J13.57, J13.59, J18.1, R75.1
/C2_LED_P7_LED0: D6.1, D8.1, J7.34, J17.3
/C3_LED_P8_LED0: D6.3, D8.3, J7.36, J17.4
/EE_CLK_C0_LED_P1_LED0_FLOW: D5.1, D7.1, J7.30, J17.1
/EE_DOUT_C1_LED_P6_LED0: D5.3, D7.3, J7.32, J17.2
/Eth_RST: J13.27, TP3.1
/MDC_CPU: J1.4, J13.33
/MDIO_CPU: J1.3, J13.35
/P1A_N: J7.5, T3.1
/P1A_P: J7.3, T3.2
/P1B_N: J7.7, T1.1
/P1B_P: J7.9, T1.2
/P1C_N: J7.13, T5.2
/P1C_P: J7.11, T5.1
/P1D_N: J7.15, T7.2
/P1D_P: J7.17, T7.1
/P2A_N: J7.23, T4.1
/P2A_P: J7.21, T4.2
/P2B_N: J7.25, T2.2
/P2B_P: J7.27, T2.1
/P2C_N: J7.31, T6.1
/P2C_P: J7.29, T6.2
/P2D_N: J7.33, T8.1
/P2D_P: J7.35, T8.2
/P3A_N: J7.41, T12.1
/P3A_P: J7.39, T12.2
/P3B_N: J7.43, T10.2
/P3B_P: J7.45, T10.1
/P3C_N: J7.49, T14.1
/P3C_P: J7.47, T14.2
/P3D_N: J7.51, T16.1
/P3D_P: J7.53, T16.2
/P4A_N: J7.42, T11.1
/P4A_P: J7.40, T11.2
/P4B_N: J7.44, T9.2
/P4B_P: J7.46, T9.1
/P4C_N: J7.50, T13.1
/P4C_P: J7.48, T13.2
/P4D_N: J7.52, T15.1
/P4D_P: J7.54, T15.2
/R0_LED_P1_LED0: J7.20, R5.1
/R0_LED_P1_LED0_R: D5.2, D5.4, D6.2, D6.4, J17.5, R5.2
/R1_LED_P2_LED0: J7.22, R4.1
/R1_LED_P2_LED0_R: D7.2, D7.4, D8.2, D8.4, J17.6, R4.2
/Transformer1G/1A_N: J4.8, L3.2
/Transformer1G/01A_N: L3.1, T3.6
/Transformer1G/1A_P: J4.7, L3.3
/Transformer1G/01A_P: L3.4, T3.7
/Transformer1G/1B_N: J4.6, L1.2
/Transformer1G/01B_N: L1.1, T1.6
/Transformer1G/1B_P: J4.5, L1.3
/Transformer1G/01B_P: L1.4, T1.7
/Transformer1G/1C_N: J4.1, L5.3
/Transformer1G/01C_N: L5.4, T5.7
/Transformer1G/1C_P: J4.2, L5.2
/Transformer1G/01C_P: L5.1, T5.6
/Transformer1G/1D_N: J4.4, L7.3
/Transformer1G/01D_N: L7.4, T7.7
/Transformer1G/1D_P: J4.3, L7.2
/Transformer1G/01D_P: L7.1, T7.6
/Transformer1G/2A_N: J5.8, L4.2
/Transformer1G/02A_N: L4.1, T4.6
/Transformer1G/2A_P: J5.7, L4.3
/Transformer1G/02A_P: L4.4, T4.7
/Transformer1G/2B_N: J5.6, L2.3
/Transformer1G/02B_N: L2.4, T2.7
/Transformer1G/2B_P: J5.5, L2.2
/Transformer1G/02B_P: L2.1, T2.6
/Transformer1G/2C_N: J5.1, L6.2
/Transformer1G/02C_N: L6.1, T6.6
/Transformer1G/2C_P: J5.2, L6.3
/Transformer1G/02C_P: L6.4, T6.7
/Transformer1G/2D_N: J5.4, L8.2
/Transformer1G/02D_N: L8.1, T8.6
/Transformer1G/2D_P: J5.3, L8.3
/Transformer1G/02D_P: L8.4, T8.7
/Transformer1G/3A_N: J8.8, L12.2
/Transformer1G/03A_N: L12.1, T12.6
/Transformer1G/3A_P: J8.7, L12.3
/Transformer1G/03A_P: L12.4, T12.7
/Transformer1G/3B_N: J8.6, L10.3
/Transformer1G/03B_N: L10.4, T10.7
/Transformer1G/3B_P: J8.5, L10.2
/Transformer1G/03B_P: L10.1, T10.6
/Transformer1G/3C_N: J8.1, L14.2
/Transformer1G/03C_N: L14.1, T14.6
/Transformer1G/3C_P: J8.2, L14.3
/Transformer1G/03C_P: L14.4, T14.7
/Transformer1G/3D_N: J8.4, L16.2
/Transformer1G/03D_N: L16.1, T16.6
/Transformer1G/3D_P: J8.3, L16.3
/Transformer1G/03D_P: L16.4, T16.7
/Transformer1G/4A_N: J9.8, L11.2
/Transformer1G/04A_N: L11.1, T11.6
/Transformer1G/4A_P: J9.7, L11.3
/Transformer1G/04A_P: L11.4, T11.7
/Transformer1G/4B_N: J9.6, L9.3
/Transformer1G/04B_N: L9.4, T9.7
/Transformer1G/4B_P: J9.5, L9.2
/Transformer1G/04B_P: L9.1, T9.6
/Transformer1G/4C_N: J9.1, L13.2
/Transformer1G/04C_N: L13.1, T13.6
/Transformer1G/4C_P: J9.2, L13.3
/Transformer1G/04C_P: L13.4, T13.7
/Transformer1G/4D_N: J9.4, L15.2
/Transformer1G/04D_N: L15.1, T15.6
/Transformer1G/4D_P: J9.3, L15.3
/Transformer1G/04D_P: L15.4, T15.7
/USART2_RX: J13.29, J18.4
/USART2_TX: J13.31, J18.3
GND: C1.1, C2.1, C3.1, C4.1, C5.1, C6.1, C7.1, C8.1, C11.1, C12.1, C13.1, C14.1, C15.1, C16.1, C17.1, C18.1, C21.1, C22.1, D12.2, D19.1, J1.2, J7.1, J7.2, J7.6, J7.12, J7.18, J7.19, J7.37, J7.38, J7.55, J7.56, J7.57, J7.59, J13.1, J13.2, J13.7, J13.13, J13.19, J13.20, J13.25, J13.37, J13.38, J13.55, J13.56, J13.58, J13.60, J16.3, J16.4, J18.2, R1.1, R8.2, R25.1
GNDPWR: C9.2, C10.2, C22.2, R1.2
GNDREF: C19.2, C20.2, C21.2, R25.2
unnamed: C1.2, T1.5
unnamed: C2.2, T2.5
unnamed: C3.2, T3.5
unnamed: C4.2, T4.5
unnamed: C5.2, T5.5
unnamed: C6.2, T6.5
unnamed: C7.2, T7.5
unnamed: C8.2, T8.5
unnamed: C9.1, R9.2, R11.2, R13.2, R15.2
unnamed: C10.1, R10.2, R12.2, R14.2, R16.2
unnamed: C11.2, T9.5
unnamed: C12.2, T10.5
unnamed: C13.2, T11.5
unnamed: C14.2, T12.5
unnamed: C15.2, T13.5
unnamed: C16.2, T14.5
unnamed: C17.2, T15.5
unnamed: C18.2, T16.5
unnamed: C19.1, R17.2, R19.2, R21.2, R23.2
unnamed: C20.1, R18.2, R20.2, R22.2, R24.2
unnamed: D11.2, Q1.1, R8.1
unnamed: D12.1, J16.1, J16.2, Q1.3, R7.2
unnamed: D19.2, R75.2
unnamed: R9.1, T1.3, T1.4
unnamed: R10.1, T2.3, T2.4
unnamed: R11.1, T3.3, T3.4
unnamed: R12.1, T4.3, T4.4
unnamed: R13.1, T5.3, T5.4
unnamed: R14.1, T6.3, T6.4
unnamed: R15.1, T7.3, T7.4
unnamed: R16.1, T8.3, T8.4
unnamed: R17.1, T9.3, T9.4
unnamed: R18.1, T10.3, T10.4
unnamed: R19.1, T11.3, T11.4
unnamed: R20.1, T12.3, T12.4
unnamed: R21.1, T13.3, T13.4
unnamed: R22.1, T14.3, T14.4
unnamed: R23.1, T15.3, T15.4
unnamed: R24.1, T16.3, T16.4
VBUS: D11.1, J7.58, J7.60, Q1.2, R7.1
