botblox/UbiSwitch-DaughterBoard-Designs/UbiSwitch DaughterBoard/Source Kicad Files/UbiConnRevA.kicad_pcb

## KiCad design UbiSwitch DaughterBoard/Source Kicad Files/UbiConnRevA.kicad_pcb (2023-10-01)

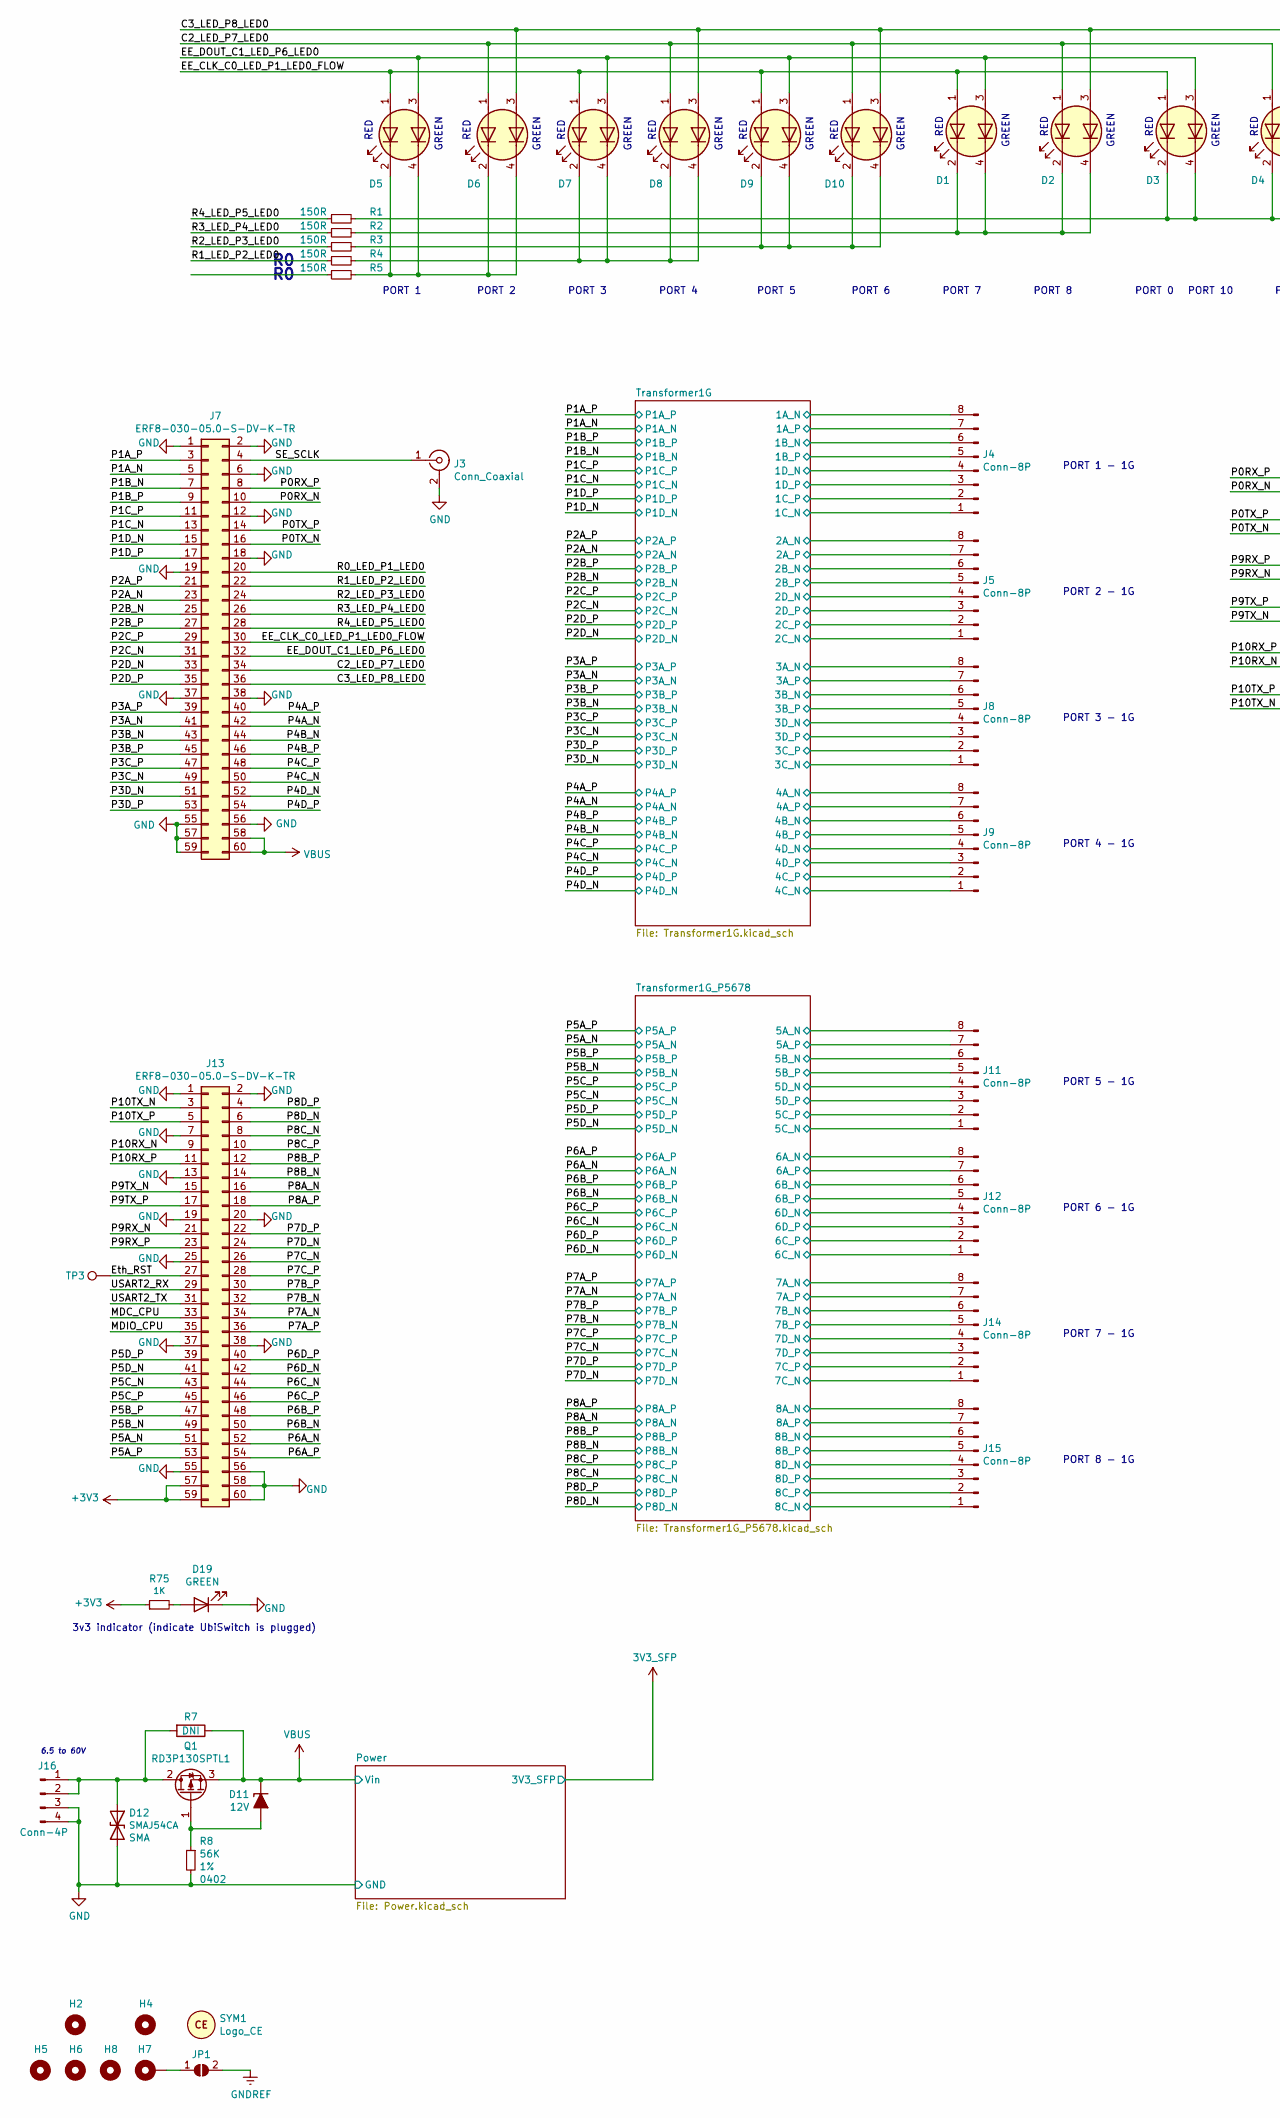
[picture p10: schematic UbiConnRevA.kicad_sch, UbiConn, part in row 1, column 1]

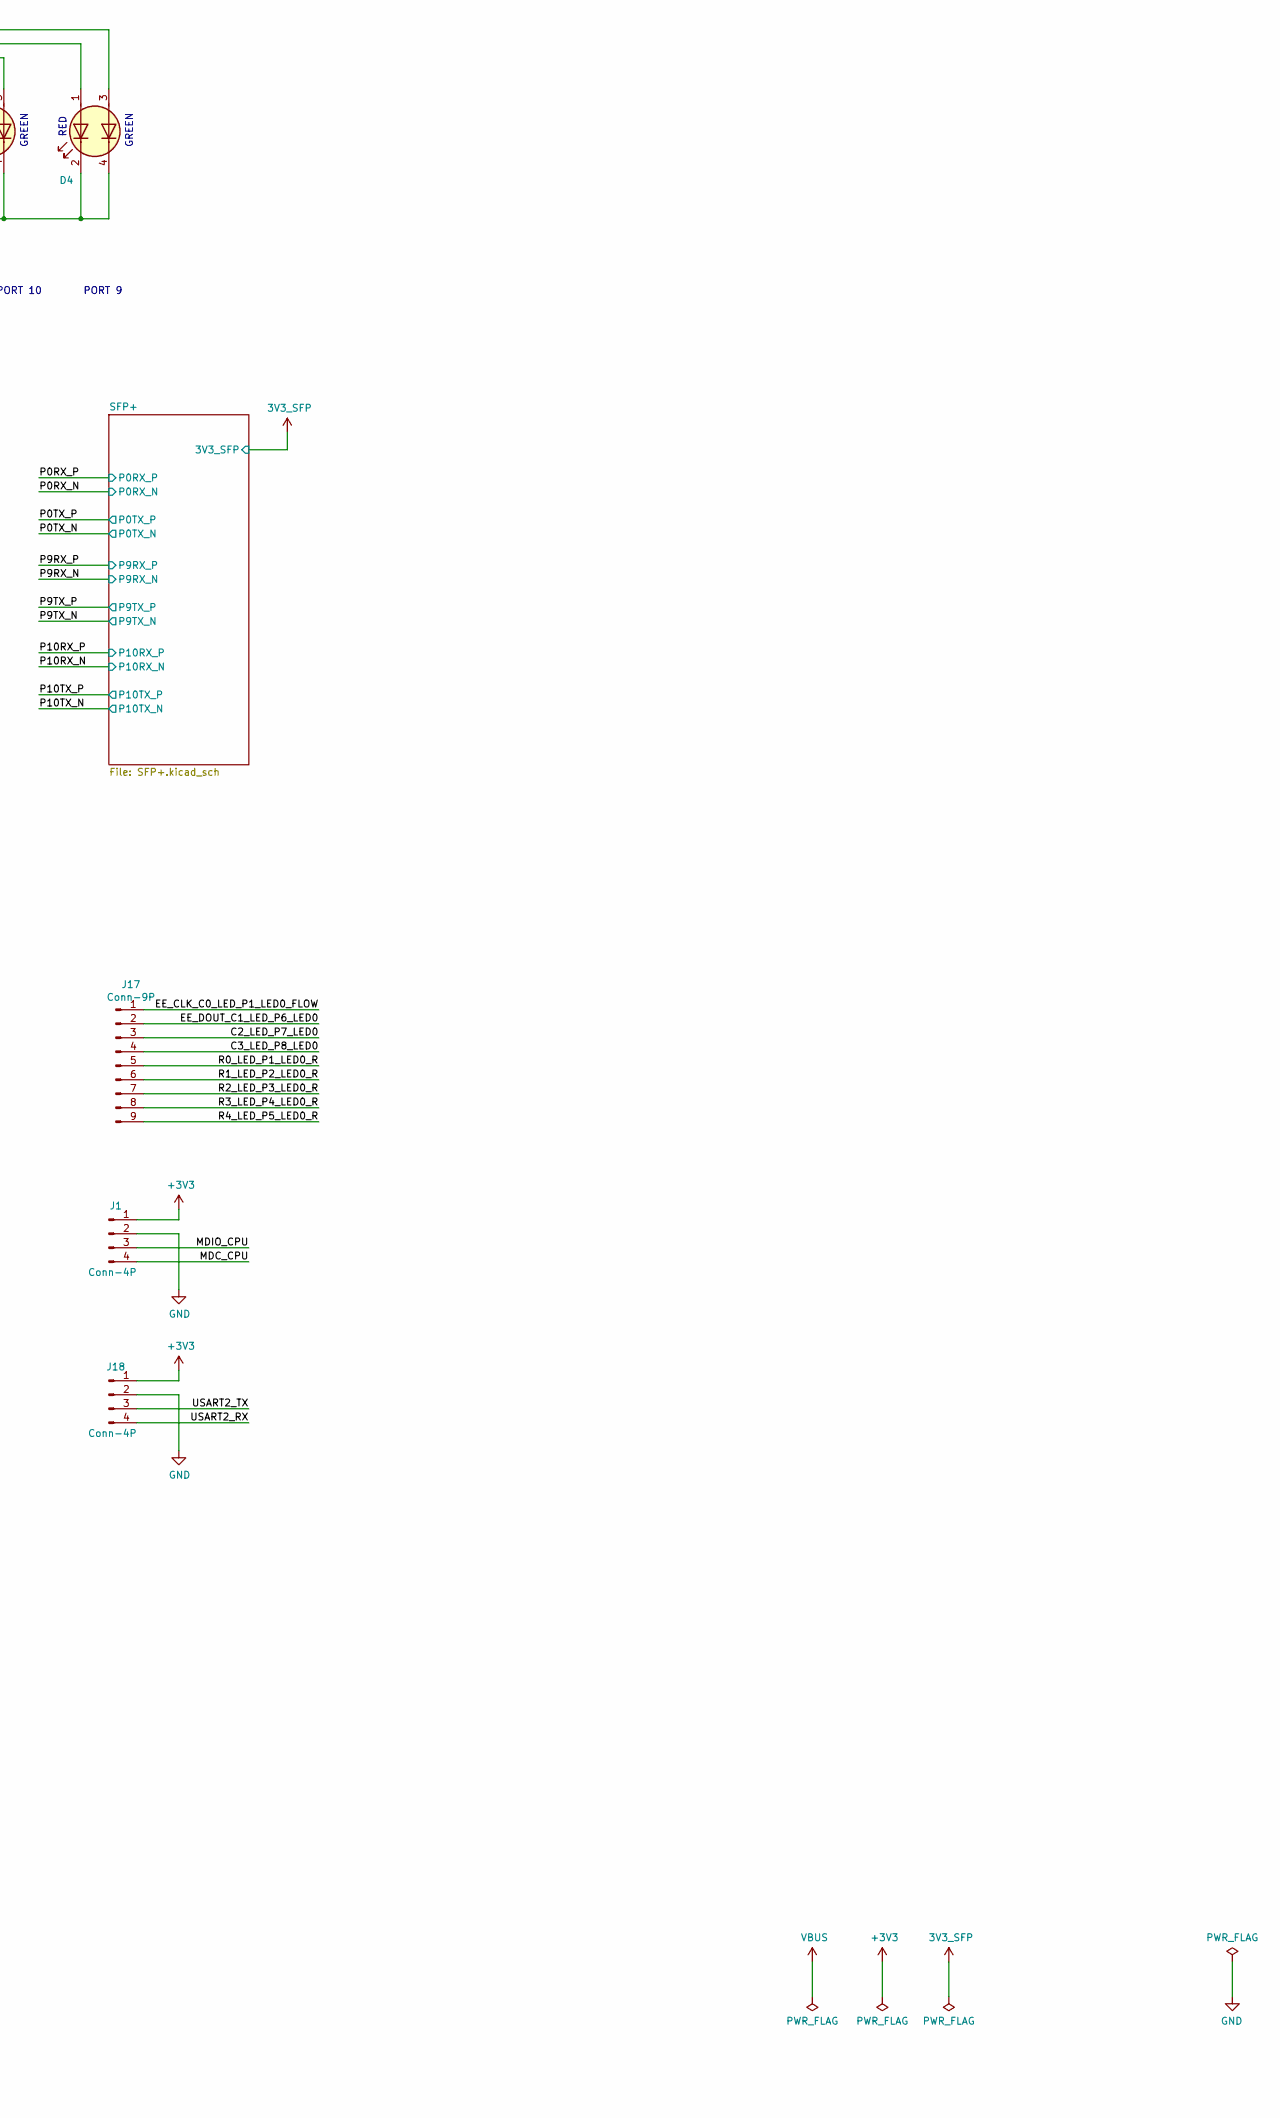
[picture p11: schematic UbiConnRevA.kicad_sch, UbiConn, part in row 1, column 2]

Parts:
D1, D2, D3, D4, D5, D6, D7, D8, D9, D10: LED_Dual_ACAC; LED_1608_ACAC; MPN LTST-C295KGKRKT; LCSC# C364568
D11: 12V; D_SOD-323; MPN MM3Z12VT1G; LCSC# C236177
D12: SMAJ54CA; D_SMA; MPN SMAJ54CA-E3/61; LCSC# C173507
D19: GREEN; LED_0603_1608Metric; MPN LTST-C191KGKT; LCSC# C125098
H2, H4, H5, H6, H7, H8: MountingHole; MountingHole_3.2mm_M3_ISO14580_Pad; MPN DNI
J1, J16, J18: Conn-4P; Molex_Pico-Clasp_501331-0407_1x04-1MP_P1.00mm_Vertical_Pico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; MPN 5013310407; LCSC# C505339
J3: Conn_Coaxial; U.FL_Hirose_U.FL-R-SMT-1_Vertical; MPN 1909763-1; LCSC# C392444
J4, J5, J8, J9, J11, J12, J14, J15: Conn-8P; Molex_Pico-Clasp_501331-0807_1x08-1MP_P1.00mm_Vertical_Pico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; MPN 5013310807; LCSC# C505340
J7, J13: ERF8-030-05.0-S-DV-K-TR; SAMTEC_ERF8-030-05.0-S-DV-K-TR; MPN ERF8-030-05.0-S-DV-K-TR
J17: Conn-9P; Molex_Pico-Clasp_501331-0907_1x09-1MP_P1.00mm_Vertical_Pico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; MPN 5013310907; LCSC# C114116
JP1: SolderJumper_2_Open; SolderJumper-2_P1.3mm_Open_RoundedPad1.0x1.5mm
Q1: RD3P130SPTL1; MPN RD3P130SPTL1; LCSC# C509778
R1, R2, R3, R4, R5: 150R; R_0402_1005Metric; Tolerance 1%; MPN RC0402FR-07150RL; LCSC# C138054
R7: DNI; R_0805_2012Metric_Pad1.20x1.40mm_HandSolder; Tolerance 1%; MPN DNI
R8: 56K; R_0402_1005Metric; Tolerance 1%; MPN RC0402FR-0756KL; LCSC# C114756
R75: 1K; R_0402_1005Metric; Tolerance 1%; MPN RC0402FR-071KL; LCSC# C106235
SYM1: Logo_CE; CE-Logo_4.3x3.1mm_SilkScreen; MPN DNI
TP3: TestPoint; TestPoint_Pad_D1.0mm; MPN DNI

Connections:
+3V3: J1.1, J13.57, J13.59, J18.1, R75.1
/C2_LED_P7_LED0: D2.1 (A1), D4.1 (A1), D6.1 (A1), D8.1 (A1), D10.1 (A1), J7.34, J17.3
/C3_LED_P8_LED0: D2.3 (A2), D4.3 (A2), D6.3 (A2), D8.3 (A2), D10.3 (A2), J7.36, J17.4
/EE_CLK_C0_LED_P1_LED0_FLOW: D1.1 (A1), D3.1 (A1), D5.1 (A1), D7.1 (A1), D9.1 (A1), J7.30, J17.1
/EE_DOUT_C1_LED_P6_LED0: D1.3 (A2), D3.3 (A2), D5.3 (A2), D7.3 (A2), D9.3 (A2), J7.32, J17.2
/Eth_RST: J13.27, TP3.1
/MDC_CPU: J1.4, J13.33
/MDIO_CPU: J1.3, J13.35
/P0RX_N: J7.10; also elsewhere on the board
/P0RX_P: J7.8; also elsewhere on the board
/P0TX_N: J7.16; also elsewhere on the board
/P0TX_P: J7.14; also elsewhere on the board
/P1A_N: J7.5; also elsewhere on the board
/P1A_P: J7.3; also elsewhere on the board
/P1B_N: J7.7; also elsewhere on the board
/P1B_P: J7.9; also elsewhere on the board
/P1C_N: J7.13; also elsewhere on the board
/P1C_P: J7.11; also elsewhere on the board
/P1D_N: J7.15; also elsewhere on the board
/P1D_P: J7.17; also elsewhere on the board
/P2A_N: J7.23; also elsewhere on the board
/P2A_P: J7.21; also elsewhere on the board
/P2B_N: J7.25; also elsewhere on the board
/P2B_P: J7.27; also elsewhere on the board
/P2C_N: J7.31; also elsewhere on the board
/P2C_P: J7.29; also elsewhere on the board
/P2D_N: J7.33; also elsewhere on the board
/P2D_P: J7.35; also elsewhere on the board
/P3A_N: J7.41; also elsewhere on the board
/P3A_P: J7.39; also elsewhere on the board
/P3B_N: J7.43; also elsewhere on the board
/P3B_P: J7.45; also elsewhere on the board
/P3C_N: J7.49; also elsewhere on the board
/P3C_P: J7.47; also elsewhere on the board
/P3D_N: J7.51; also elsewhere on the board
/P3D_P: J7.53; also elsewhere on the board
/P4A_N: J7.42; also elsewhere on the board
/P4A_P: J7.40; also elsewhere on the board
/P4B_N: J7.44; also elsewhere on the board
/P4B_P: J7.46; also elsewhere on the board
/P4C_N: J7.50; also elsewhere on the board
/P4C_P: J7.48; also elsewhere on the board
/P4D_N: J7.52; also elsewhere on the board
/P4D_P: J7.54; also elsewhere on the board
/P5A_N: J13.51; also elsewhere on the board
/P5A_P: J13.53; also elsewhere on the board
/P5B_N: J13.49; also elsewhere on the board
/P5B_P: J13.47; also elsewhere on the board
/P5C_N: J13.43; also elsewhere on the board
/P5C_P: J13.45; also elsewhere on the board
/P5D_N: J13.41; also elsewhere on the board
/P5D_P: J13.39; also elsewhere on the board
/P6A_N: J13.52; also elsewhere on the board
/P6A_P: J13.54; also elsewhere on the board
/P6B_N: J13.50; also elsewhere on the board
/P6B_P: J13.48; also elsewhere on the board
/P6C_N: J13.44; also elsewhere on the board
/P6C_P: J13.46; also elsewhere on the board
/P6D_N: J13.42; also elsewhere on the board
/P6D_P: J13.40; also elsewhere on the board
/P7A_N: J13.34; also elsewhere on the board
/P7A_P: J13.36; also elsewhere on the board
/P7B_N: J13.32; also elsewhere on the board
/P7B_P: J13.30; also elsewhere on the board
/P7C_N: J13.26; also elsewhere on the board
/P7C_P: J13.28; also elsewhere on the board
/P7D_N: J13.24; also elsewhere on the board
/P7D_P: J13.22; also elsewhere on the board
/P8A_N: J13.16; also elsewhere on the board
/P8A_P: J13.18; also elsewhere on the board
/P8B_N: J13.14; also elsewhere on the board
/P8B_P: J13.12; also elsewhere on the board
/P8C_N: J13.8; also elsewhere on the board
/P8C_P: J13.10; also elsewhere on the board
/P8D_N: J13.6; also elsewhere on the board
/P8D_P: J13.4; also elsewhere on the board
/P9RX_N: J13.21; also elsewhere on the board
/P9RX_P: J13.23; also elsewhere on the board
/P9TX_N: J13.15; also elsewhere on the board
/P9TX_P: J13.17; also elsewhere on the board
/P10RX_N: J13.9; also elsewhere on the board
/P10RX_P: J13.11; also elsewhere on the board
/P10TX_N: J13.3; also elsewhere on the board
/P10TX_P: J13.5; also elsewhere on the board
/R0_LED_P1_LED0: J7.20, R5.1
/R1_LED_P2_LED0: J7.22, R4.1
/R2_LED_P3_LED0: J7.24, R3.1
/R3_LED_P4_LED0: J7.26, R2.1
/R4_LED_P5_LED0: J7.28, R1.1
/SE_SCLK: J3.1 (In), J7.4
/Transformer1G/1A_N: J4.8; also elsewhere on the board
/Transformer1G/1A_P: J4.7; also elsewhere on the board
/Transformer1G/1B_N: J4.6; also elsewhere on the board
/Transformer1G/1B_P: J4.5; also elsewhere on the board
/Transformer1G/1C_N: J4.1; also elsewhere on the board
/Transformer1G/1C_P: J4.2; also elsewhere on the board
/Transformer1G/1D_N: J4.4; also elsewhere on the board
/Transformer1G/1D_P: J4.3; also elsewhere on the board
/Transformer1G/2A_N: J5.8; also elsewhere on the board
/Transformer1G/2A_P: J5.7; also elsewhere on the board
/Transformer1G/2B_N: J5.6; also elsewhere on the board
/Transformer1G/2B_P: J5.5; also elsewhere on the board
/Transformer1G/2C_N: J5.1; also elsewhere on the board
/Transformer1G/2C_P: J5.2; also elsewhere on the board
/Transformer1G/2D_N: J5.4; also elsewhere on the board
/Transformer1G/2D_P: J5.3; also elsewhere on the board
/Transformer1G/3A_N: J8.8; also elsewhere on the board
/Transformer1G/3A_P: J8.7; also elsewhere on the board
/Transformer1G/3B_N: J8.6; also elsewhere on the board
/Transformer1G/3B_P: J8.5; also elsewhere on the board
/Transformer1G/3C_N: J8.1; also elsewhere on the board
/Transformer1G/3C_P: J8.2; also elsewhere on the board
/Transformer1G/3D_N: J8.4; also elsewhere on the board
/Transformer1G/3D_P: J8.3; also elsewhere on the board
/Transformer1G/4A_N: J9.8; also elsewhere on the board
/Transformer1G/4A_P: J9.7; also elsewhere on the board
/Transformer1G/4B_N: J9.6; also elsewhere on the board
/Transformer1G/4B_P: J9.5; also elsewhere on the board
/Transformer1G/4C_N: J9.1; also elsewhere on the board
/Transformer1G/4C_P: J9.2; also elsewhere on the board
/Transformer1G/4D_N: J9.4; also elsewhere on the board
/Transformer1G/4D_P: J9.3; also elsewhere on the board
/Transformer1G_P5678/5A_N: J11.8; also elsewhere on the board
/Transformer1G_P5678/5A_P: J11.7; also elsewhere on the board
/Transformer1G_P5678/5B_N: J11.6; also elsewhere on the board
/Transformer1G_P5678/5B_P: J11.5; also elsewhere on the board
/Transformer1G_P5678/5C_N: J11.1; also elsewhere on the board
/Transformer1G_P5678/5C_P: J11.2; also elsewhere on the board
/Transformer1G_P5678/5D_N: J11.4; also elsewhere on the board
/Transformer1G_P5678/5D_P: J11.3; also elsewhere on the board
/Transformer1G_P5678/6A_N: J12.8; also elsewhere on the board
/Transformer1G_P5678/6A_P: J12.7; also elsewhere on the board
/Transformer1G_P5678/6B_N: J12.6; also elsewhere on the board
/Transformer1G_P5678/6B_P: J12.5; also elsewhere on the board
/Transformer1G_P5678/6C_N: J12.1; also elsewhere on the board
/Transformer1G_P5678/6C_P: J12.2; also elsewhere on the board
/Transformer1G_P5678/6D_N: J12.4; also elsewhere on the board
/Transformer1G_P5678/6D_P: J12.3; also elsewhere on the board
/Transformer1G_P5678/7A_N: J14.8; also elsewhere on the board
/Transformer1G_P5678/7A_P: J14.7; also elsewhere on the board
/Transformer1G_P5678/7B_N: J14.6; also elsewhere on the board
/Transformer1G_P5678/7B_P: J14.5; also elsewhere on the board
/Transformer1G_P5678/7C_N: J14.1; also elsewhere on the board
/Transformer1G_P5678/7C_P: J14.2; also elsewhere on the board
/Transformer1G_P5678/7D_N: J14.4; also elsewhere on the board
/Transformer1G_P5678/7D_P: J14.3; also elsewhere on the board
/Transformer1G_P5678/8A_N: J15.8; also elsewhere on the board
/Transformer1G_P5678/8A_P: J15.7; also elsewhere on the board
/Transformer1G_P5678/8B_N: J15.6; also elsewhere on the board
/Transformer1G_P5678/8B_P: J15.5; also elsewhere on the board
/Transformer1G_P5678/8C_N: J15.1; also elsewhere on the board
/Transformer1G_P5678/8C_P: J15.2; also elsewhere on the board
/Transformer1G_P5678/8D_N: J15.4; also elsewhere on the board
/Transformer1G_P5678/8D_P: J15.3; also elsewhere on the board
/USART2_RX: J13.29, J18.4
/USART2_TX: J13.31, J18.3
GND: D12.2 (A2), D19.1 (K), J1.2, J3.2 (Ext), J7.1, J7.2, J7.6, J7.12, J7.18, J7.19, J7.37, J7.38, J7.55, J7.56, J7.57, J7.59, J13.1, J13.2, J13.7, J13.13, J13.19, J13.20, J13.25, J13.37, J13.38, J13.55, J13.56, J13.58, J13.60, J16.3, J16.4, J18.2, R8.2; also elsewhere on the board
GNDREF: JP1.2 (B); also elsewhere on the board
unnamed: D11.2 (A), Q1.1 (G), R8.1
unnamed: D12.1 (A1), J16.1, J16.2, Q1.2 (D), R7.2
unnamed: D19.2 (A), R75.2
unnamed: H7.1, JP1.1 (A)
VBUS: D11.1 (K), J7.58, J7.60, Q1.3 (S), R7.1; also elsewhere on the board

Notes on the sheet:
PORT 10
3v3 indicator (indicate UbiSwitch is plugged)
PORT 9
RED
GREEN
PORT 8 - 1G
PORT 6
PORT 0
PORT 7 - 1G
PORT 1 - 1G
PORT 3 - 1G
PORT 7
PORT 5 - 1G
PORT 2 - 1G
PORT 1
PORT 4 - 1G
PORT 5
PORT 8
PORT 2
PORT 4
PORT 3
6.5 to 60V
PORT 6 - 1G

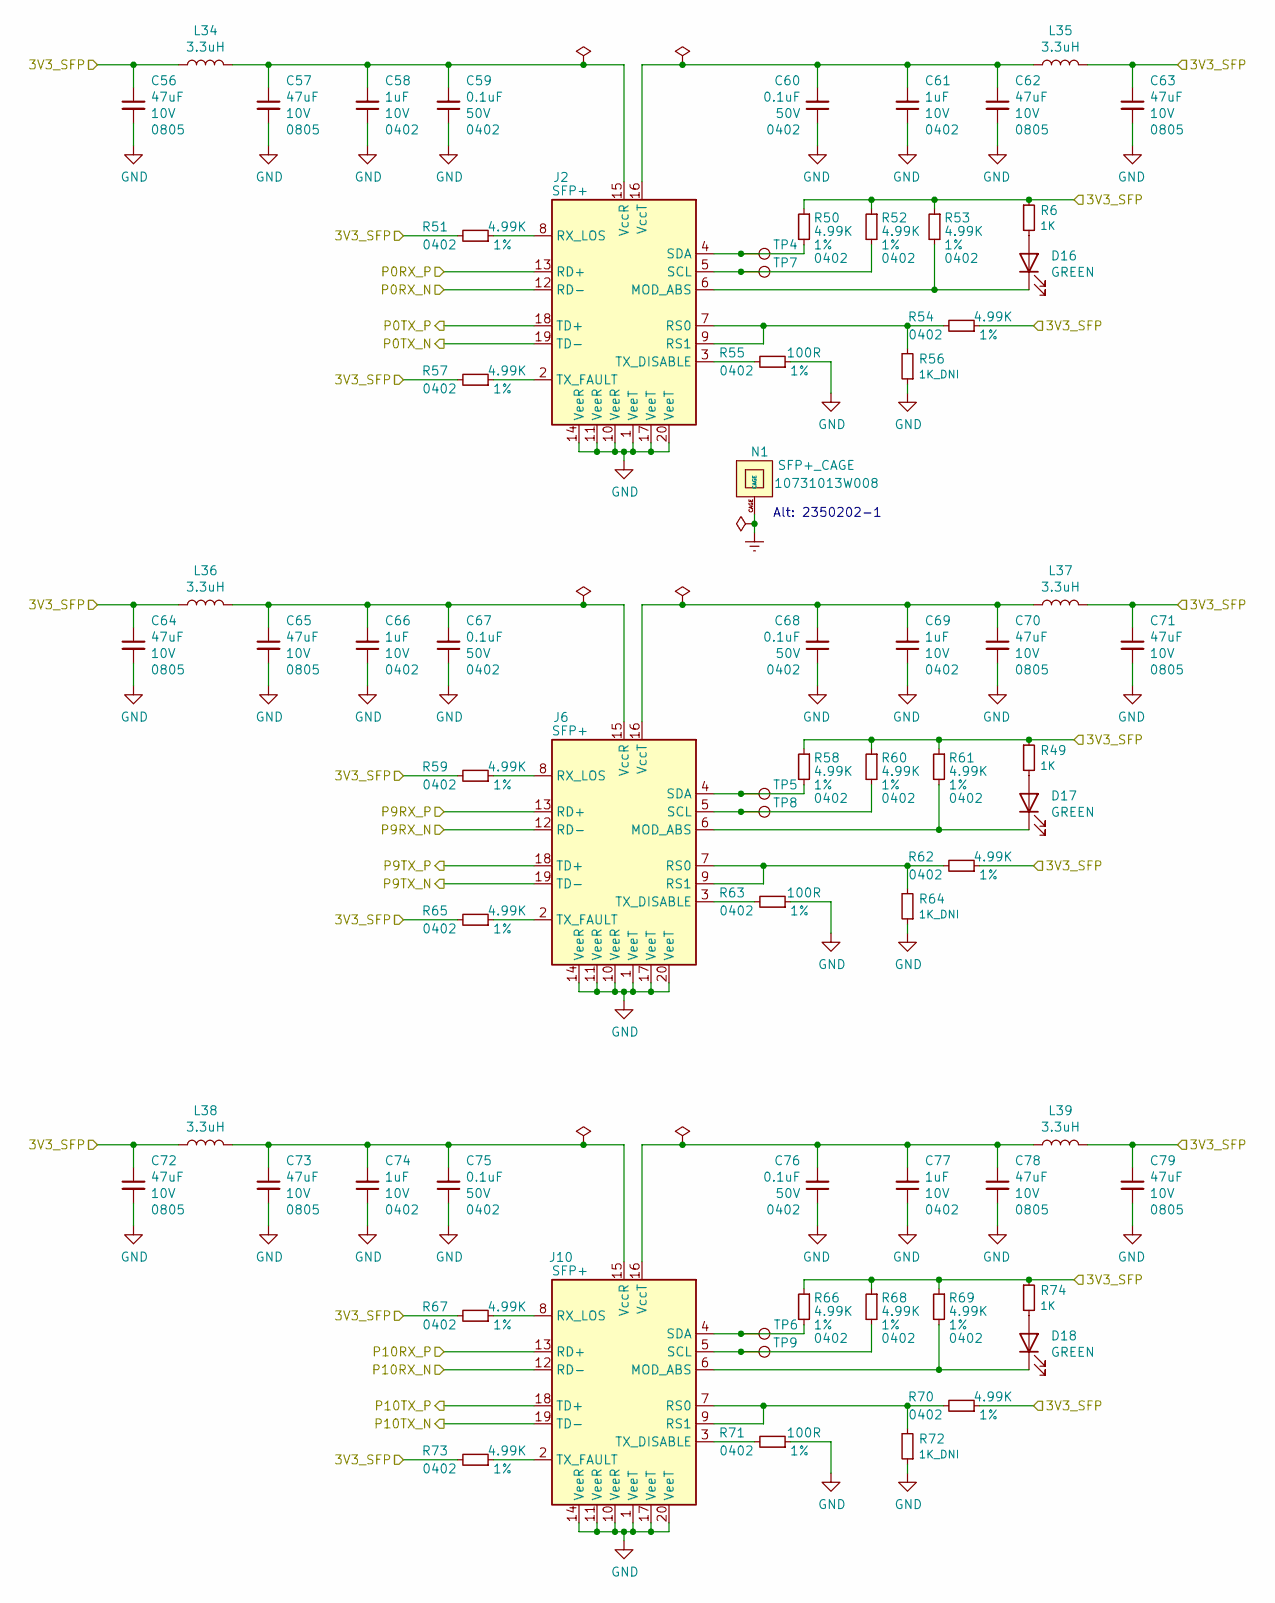
[picture p12: schematic SFP+.kicad_sch, UbiConn]

Parts:
C56, C57, C62, C63, C64, C65, C70, C71, C72, C73, C78, C79: 47uF; C_0805_2012Metric; Voltage Rating 10V; MPN C2012X5R1A476MTJ00E; LCSC# C76636
C58, C61, C66, C69, C74, C77: 1uF; C_0402_Small; Voltage Rating 10V; MPN GRM155C81A105KA12D; LCSC# C162161
C59, C60, C67, C68, C75, C76: 0.1uF; C_0402_Small; Voltage Rating 50V; MPN GRM155R71H104KE14J; LCSC# C85858
D16, D17, D18: GREEN; LED_0603_1608Metric; MPN LTST-C191KGKT; LCSC# C125098
J2, J6, J10: SFP+; Connector_SFP; MPN 0744410001; LCSC# C277615
L34, L35, L36, L37, L38, L39: 3.3uH; L_1008_2520Metric; MPN DFE252012F-3R3M=P2; LCSC# C2041573
N1: SFP+_CAGE; Connector_SFP_and_Cage_10731013W008_CZT; MPN 10731013W008
R6, R49, R74: 1K; R_0402_1005Metric; Tolerance 1%; MPN RC0402FR-071KL; LCSC# C106235
R50, R51, R52, R53, R54, R57, R58, R59, R60, R61, R62, R65, R66, R67, R68, R69, R70, R73: 4.99K; R_0402_1005Metric; Tolerance 1%; MPN RC0402FR-074K99L; LCSC# C137965
R55, R63, R71: 100R; R_0402_1005Metric; Tolerance 1%; MPN RC0402FR-07100RL; LCSC# C106232
R56, R64, R72: 1K_DNI; R_0402_1005Metric; MPN DNI
TP4, TP5, TP6, TP7, TP8, TP9: TestPoint; TestPoint_Pad_D1.0mm; MPN DNI

Connections:
3V3_SFP: C56.1, C63.1, C64.1, C71.1, C72.1, C79.1, L34.1, L35.1, L36.1, L37.1, L38.1, L39.1, R6.1, R49.1, R50.1, R51.2, R52.1, R53.1, R54.1, R57.2, R58.1, R59.2, R60.1, R61.1, R62.1, R65.2, R66.1, R67.2, R68.1, R69.1, R70.1, R73.2, R74.1; also elsewhere on the board
/P0RX_N: J2.12 (RD-); also elsewhere on the board
/P0RX_P: J2.13 (RD+); also elsewhere on the board
/P0TX_N: J2.19 (TD-); also elsewhere on the board
/P0TX_P: J2.18 (TD+); also elsewhere on the board
/P9RX_N: J6.12 (RD-); also elsewhere on the board
/P9RX_P: J6.13 (RD+); also elsewhere on the board
/P9TX_N: J6.19 (TD-); also elsewhere on the board
/P9TX_P: J6.18 (TD+); also elsewhere on the board
/P10RX_N: J10.12 (RD-); also elsewhere on the board
/P10RX_P: J10.13 (RD+); also elsewhere on the board
/P10TX_N: J10.19 (TD-); also elsewhere on the board
/P10TX_P: J10.18 (TD+); also elsewhere on the board
Earth: N1.CAGE
GND: C56.2, C57.2, C58.1, C59.1, C60.1, C61.1, C62.2, C63.2, C64.2, C65.2, C66.1, C67.1, C68.1, C69.1, C70.2, C71.2, C72.2, C73.2, C74.1, C75.1, C76.1, C77.1, C78.2, C79.2, J2.1 (VeeT), J2.10 (VeeR), J2.11 (VeeR), J2.14 (VeeR), J2.17 (VeeT), J2.20 (VeeT), J6.1 (VeeT), J6.10 (VeeR), J6.11 (VeeR), J6.14 (VeeR), J6.17 (VeeT), J6.20 (VeeT), J10.1 (VeeT), J10.10 (VeeR), J10.11 (VeeR), J10.14 (VeeR), J10.17 (VeeT), J10.20 (VeeT), R55.1, R56.1, R63.1, R64.1, R71.1, R72.1; also elsewhere on the board
unnamed: C57.1, C58.2, C59.2, J2.15 (VccR), L34.2
unnamed: C60.2, C61.2, C62.1, J2.16 (VccT), L35.2
unnamed: C65.1, C66.2, C67.2, J6.15 (VccR), L36.2
unnamed: C68.2, C69.2, C70.1, J6.16 (VccT), L37.2
unnamed: C73.1, C74.2, C75.2, J10.15 (VccR), L38.2
unnamed: C76.2, C77.2, C78.1, J10.16 (VccT), L39.2
unnamed: D16.1 (K), J2.6 (MOD_ABS), R53.2
unnamed: D16.2 (A), R6.2
unnamed: D17.1 (K), J6.6 (MOD_ABS), R61.2
unnamed: D17.2 (A), R49.2
unnamed: D18.1 (K), J10.6 (MOD_ABS), R69.2
unnamed: D18.2 (A), R74.2
unnamed: J2.2 (TX_FAULT), R57.1
unnamed: J2.3 (TX_DISABLE), R55.2
unnamed: J2.4 (SDA), R50.2, TP4.1
unnamed: J2.5 (SCL), R52.2, TP7.1
unnamed: J2.7 (RS0), J2.9 (RS1), R54.2, R56.2
unnamed: J2.8 (RX_LOS), R51.1
unnamed: J6.2 (TX_FAULT), R65.1
unnamed: J6.3 (TX_DISABLE), R63.2
unnamed: J6.4 (SDA), R58.2, TP5.1
unnamed: J6.5 (SCL), R60.2, TP8.1
unnamed: J6.7 (RS0), J6.9 (RS1), R62.2, R64.2
unnamed: J6.8 (RX_LOS), R59.1
unnamed: J10.2 (TX_FAULT), R73.1
unnamed: J10.3 (TX_DISABLE), R71.2
unnamed: J10.4 (SDA), R66.2, TP6.1
unnamed: J10.5 (SCL), R68.2, TP9.1
unnamed: J10.7 (RS0), J10.9 (RS1), R70.2, R72.2
unnamed: J10.8 (RX_LOS), R67.1

Notes on the sheet:
Alt: 2350202-1
