botblox/UbiSwitch-DaughterBoard-Designs/UbiSwitch DaughterBoard/Source Kicad Files/UbiConnRevA.kicad_pcb

## KiCad design UbiSwitch DaughterBoard/Source Kicad Files/UbiConnRevA.kicad_pcb (continued)

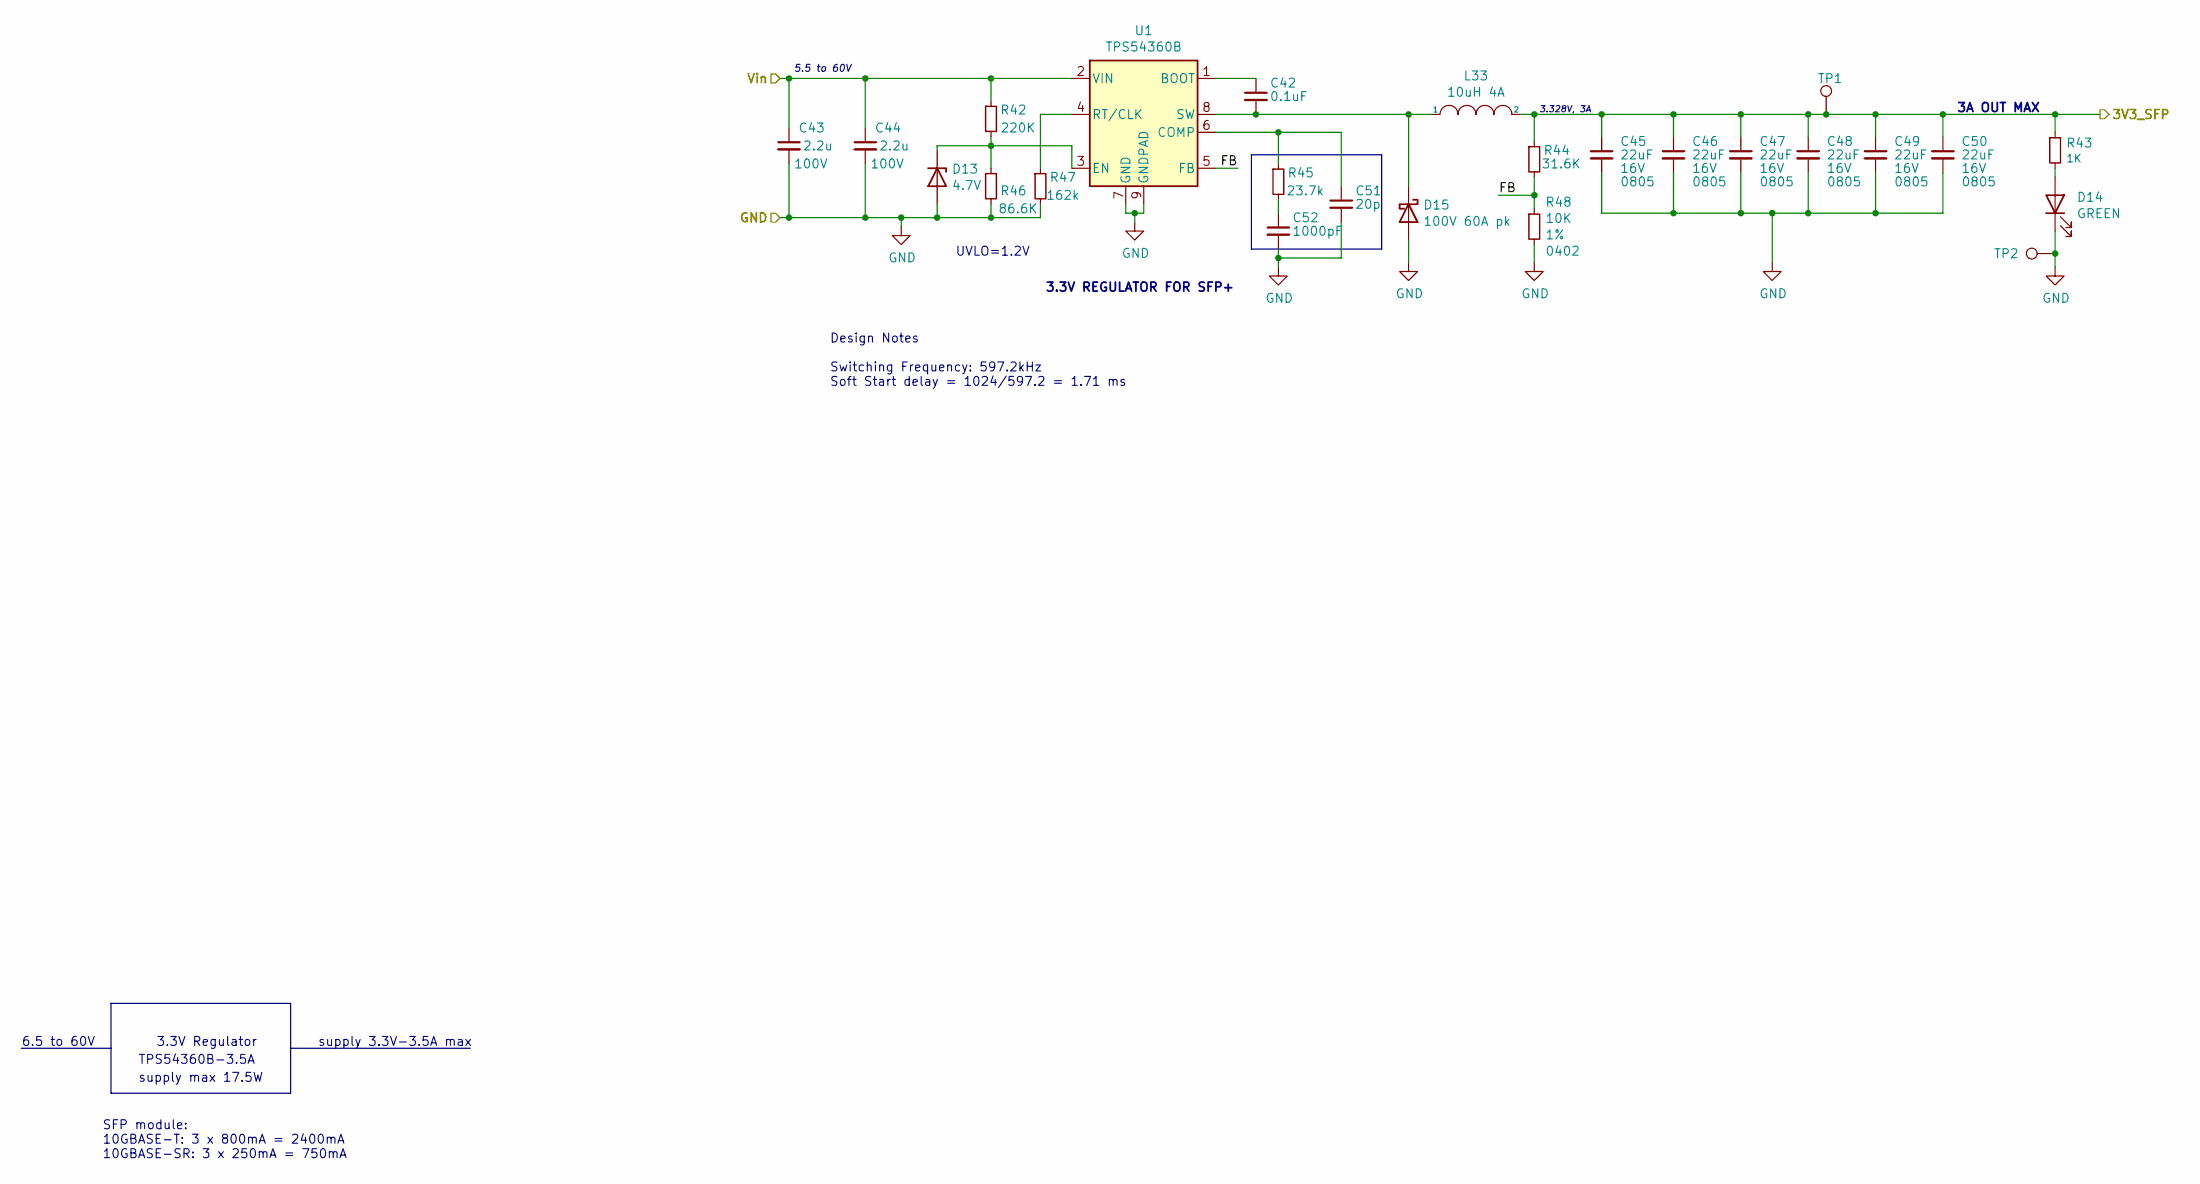
[picture p13: schematic Power.kicad_sch, UbiConn]

Parts:
C42: 0.1uF; C_0402_Small; Voltage Rating 50V; MPN GRM155R71H104KE14J; LCSC# C85858
C43, C44: 2.2u; C_1206_3216Metric; Voltage Rating 100V; MPN CL31B225KCHSNNE; LCSC# C170101
C45, C46, C47, C48, C49, C50: 22uF; C_0805_2012Metric; Voltage Rating 16V; MPN CL21X226MOYNNWE; LCSC# C3039691
C51: 20p; C_0402_Small; Voltage Rating 50V; MPN CC0402JRNPO9BN200; LCSC# C107000
C52: 1000pF; C_0402_Small; Voltage Rating 50V; MPN 0402B102K500CT; LCSC# C301925
D13: 4.7V; D_SOD-323F; MPN BZX84J-C4V7,115; LCSC# C551023
D14: GREEN; LED_0603_1608Metric; MPN LTST-C191KGKT; LCSC# C125098
D15: 100V 60A pk; D_SMA; MPN VSSA310S-E3/61T; LCSC# C468173
L33: 10uH 4A; L_7.3x6.6_H3; MPN LMLP07A7M100DTAS
R42: 220K; R_0402_1005Metric; Tolerance 1%; MPN RC0402FR-07220KL; LCSC# C138030
R43: 1K; R_0402_1005Metric; Tolerance 1%; MPN RC0402FR-071KL; LCSC# C106235
R44: 31.6K; R_0402_1005Metric; Tolerance 1%; MPN RC0402FR-0731K6L; LCSC# C276265
R45: 23.7k; R_0402_1005Metric; Tolerance 1%; MPN RC0402FR-0723K7L; LCSC# C327362
R46: 86.6K; R_0402_1005Metric; Tolerance 1%; MPN RC0402FR-0786K6L; LCSC# C477807
R47: 162k; R_0402_1005Metric; Tolerance 1%; MPN RC0402FR-07162KL; LCSC# C185462
R48: 10K; R_0402_1005Metric; Tolerance 1%; MPN RC0402FR-0710KL; LCSC# C60490
TP1, TP2: TestPoint; TestPoint_Pad_D1.0mm; MPN DNI
U1: TPS54360B; TI_SO-PowerPAD-8_ThermalVias; MPN TPS54360BDDAR; LCSC# C524806

Connections:
3V3_SFP: C45.1, C46.1, C47.1, C48.1, C49.1, C50.1, L33.2, R43.1, R44.1, TP1.1; also elsewhere on the board
/Power/FB: R44.2, R48.1, U1.5 (FB)
GND: C43.2, C44.2, C45.2, C46.2, C47.2, C48.2, C49.2, C50.2, C51.2, C52.2, D13.2 (A), D14.1 (K), D15.2 (A), R46.2, R47.2, R48.2, TP2.1, U1.7 (GND), U1.9 (GNDPAD); also elsewhere on the board
unnamed: C42.1, U1.1 (BOOT)
unnamed: C42.2, D15.1 (K), L33.1, U1.8 (SW)
unnamed: C51.1, R45.1, U1.6 (COMP)
unnamed: C52.1, R45.2
unnamed: D13.1 (K), R42.2, R46.1, U1.3 (EN)
unnamed: D14.2 (A), R43.2
unnamed: R47.1, U1.4 (RT/CLK)
VBUS: C43.1, C44.1, R42.1, U1.2 (VIN); also elsewhere on the board

Notes on the sheet:
3A OUT MAX
3.3V REGULATOR FOR SFP+
Design Notes Switching Frequency: 597.2kHz Soft Start delay = 1024/597.2 = 1.71 ms
SFP module: 10GBASE-T: 3 x 800mA = 2400mA 10GBASE-SR: 3 x 250mA = 750mA
3.328V, 3A
5.5 to 60V
TPS54360B-3.5A
6.5 to 60V
UVLO=1.2V
supply 3.3V-3.5A max
supply max 17.5W
3.3V Regulator

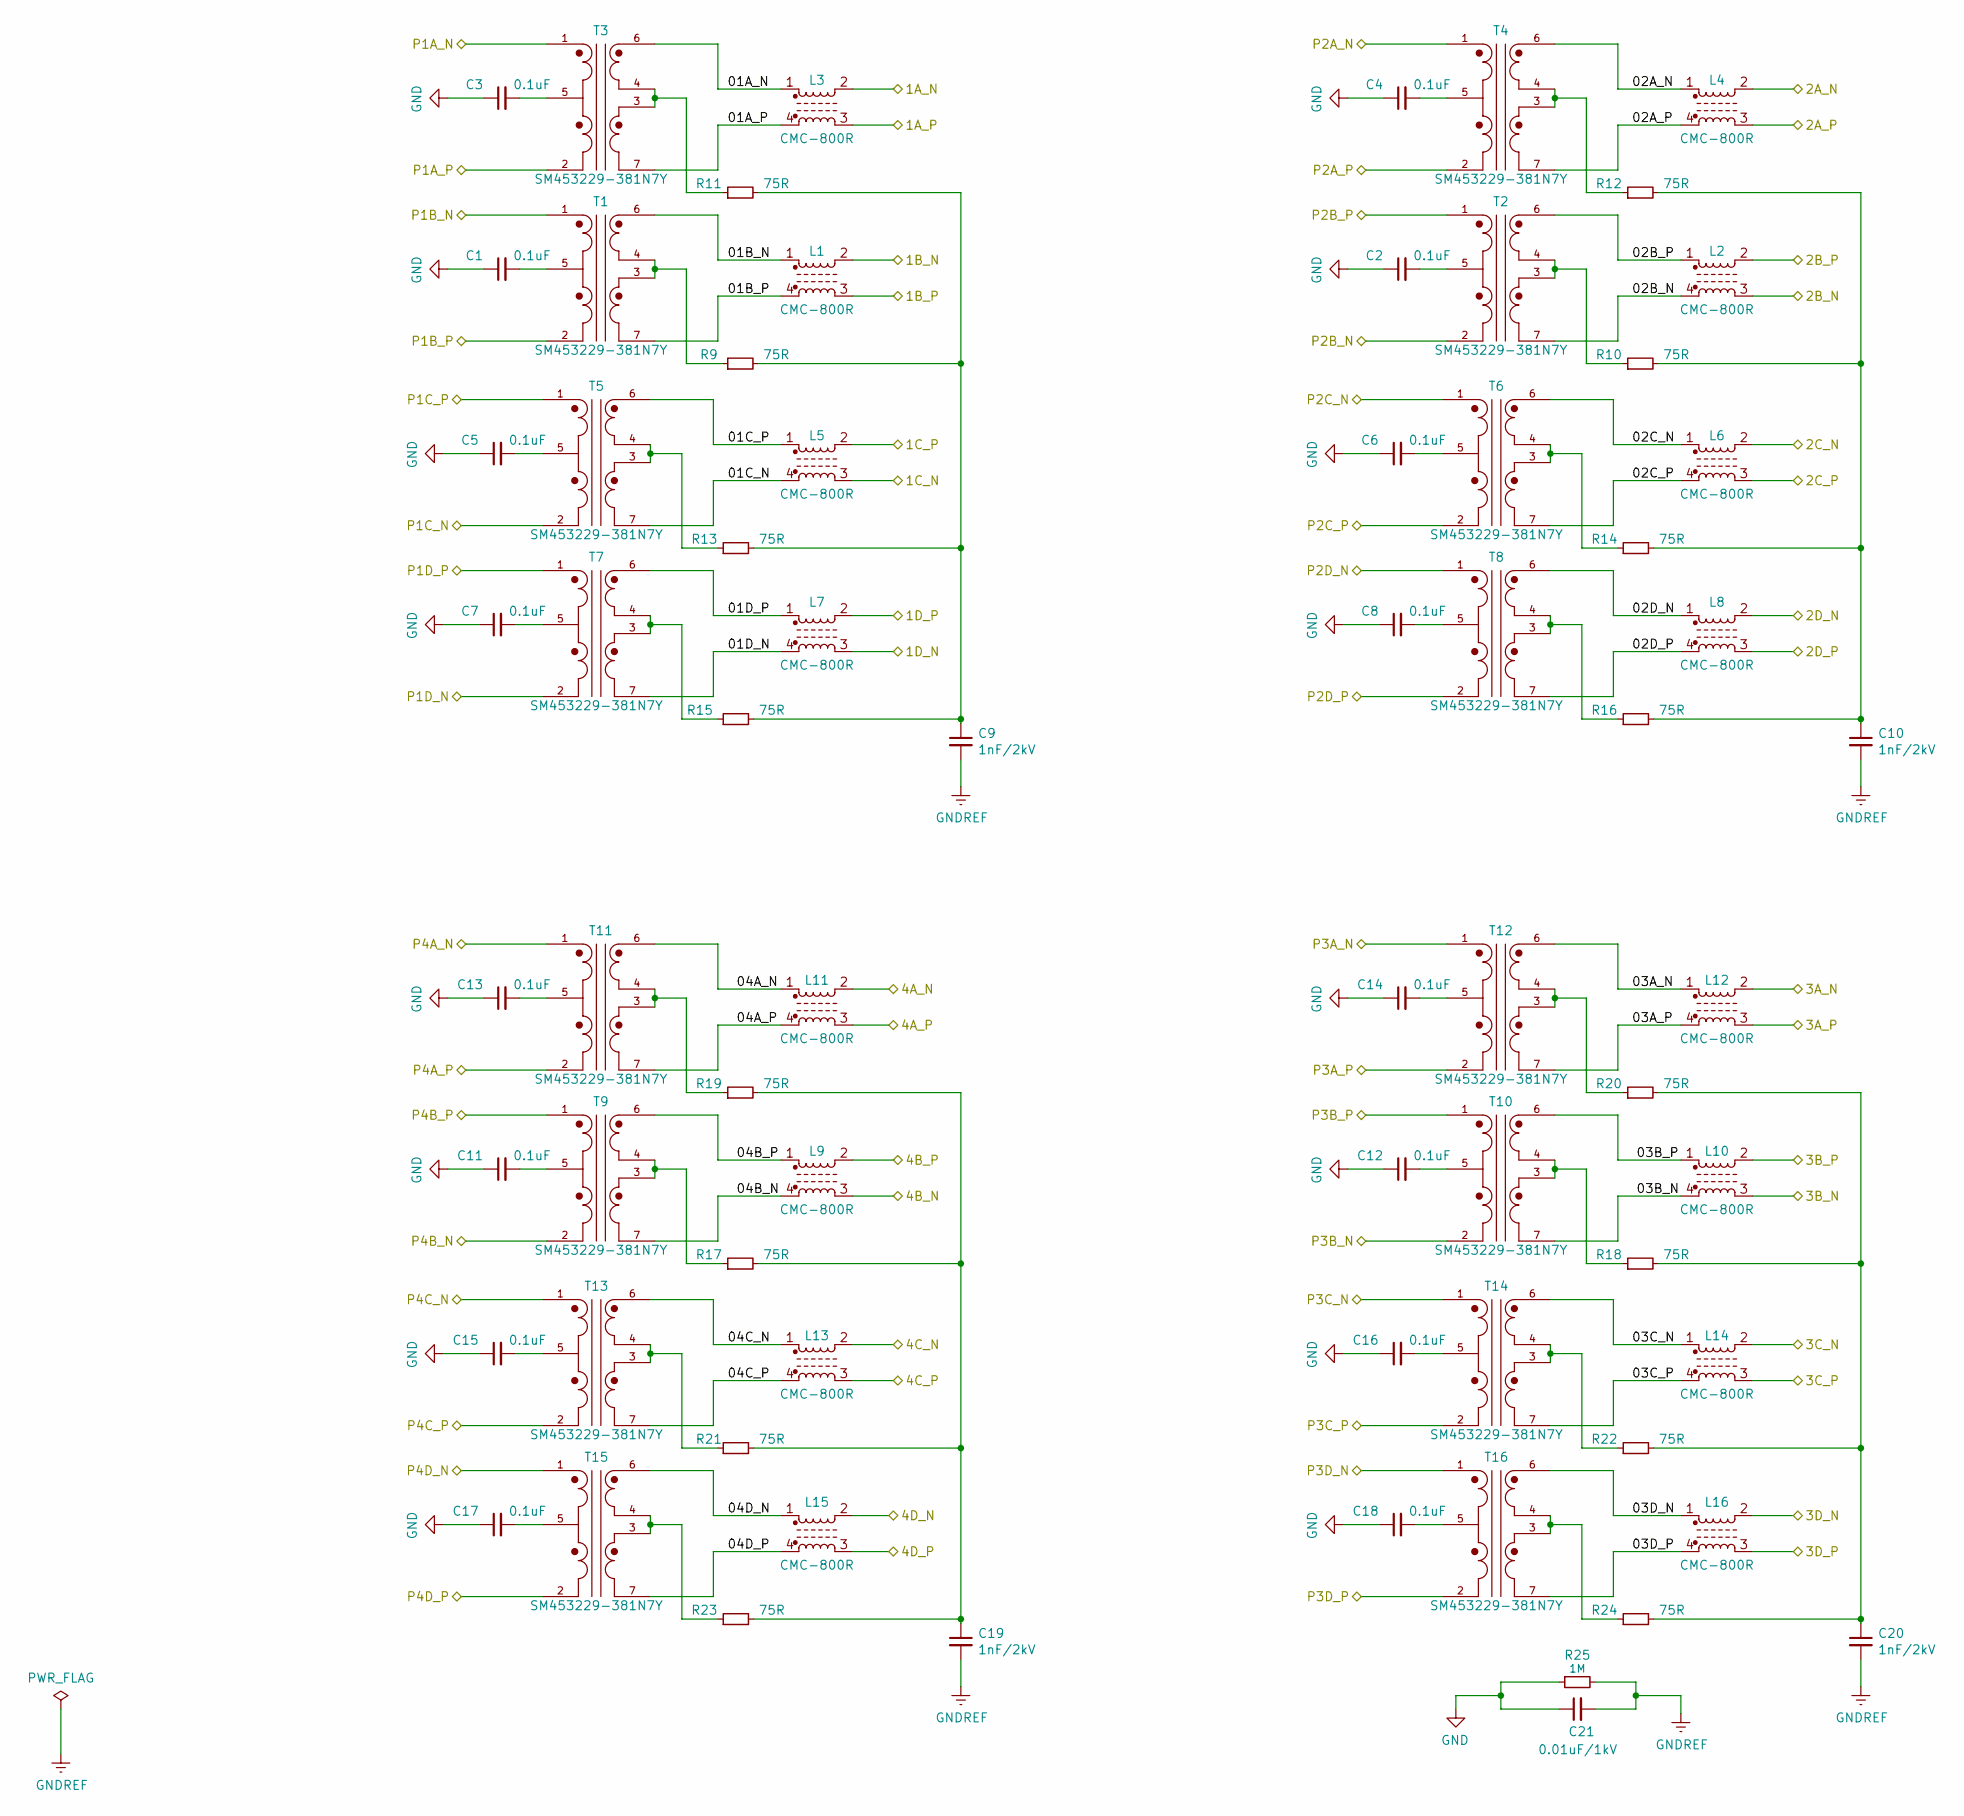
[picture p14: schematic Transformer1G.kicad_sch, UbiConn]

Parts:
C1, C2, C3, C4, C5, C6, C7, C8, C11, C12, C13, C14, C15, C16, C17, C18: 0.1uF; C_0402_Small; Voltage Rating 50V; MPN GRM155R71H104KE14J; LCSC# C85858
C9, C10, C19, C20: 1nF/2kV; C_1206_3216Metric; Voltage Rating 2KV; MPN CC1206KKX7RDBB102; LCSC# C23631
C21: 0.01uF/1kV; C_1206_3216Metric; Voltage Rating 1KV; MPN CC1206KKX7RCBB103; LCSC# C107192
L1, L2, L3, L4, L5, L6, L7, L8, L9, L10, L11, L12, L13, L14, L15, L16: CMC-800R; SRF2012A-801Y; MPN CND-WCM0805M801-2; LCSC# C3020807
R9, R10, R11, R12, R13, R14, R15, R16, R17, R18, R19, R20, R21, R22, R23, R24: 75R; R_0402_1005Metric; Tolerance 1%; MPN RC0402FR-0775RL; LCSC# C114757
R25: 1M; R_1206_3216Metric; Tolerance 1%; MPN RC1206JR-071ML; LCSC# C148194
T1, T2, T3, T4, T5, T6, T7, T8, T9, T10, T11, T12, T13, T14, T15, T16: SM453229-381N7Y; SM453229-381N7Y_thinner; MPN SM453229-381N7Y; LCSC# C913239

Connections:
/P1A_N: T3.1; also elsewhere on the board
/P1A_P: T3.2; also elsewhere on the board
/P1B_N: T1.1; also elsewhere on the board
/P1B_P: T1.2; also elsewhere on the board
/P1C_N: T5.2; also elsewhere on the board
/P1C_P: T5.1; also elsewhere on the board
/P1D_N: T7.2; also elsewhere on the board
/P1D_P: T7.1; also elsewhere on the board
/P2A_N: T4.1; also elsewhere on the board
/P2A_P: T4.2; also elsewhere on the board
/P2B_N: T2.2; also elsewhere on the board
/P2B_P: T2.1; also elsewhere on the board
/P2C_N: T6.1; also elsewhere on the board
/P2C_P: T6.2; also elsewhere on the board
/P2D_N: T8.1; also elsewhere on the board
/P2D_P: T8.2; also elsewhere on the board
/P3A_N: T12.1; also elsewhere on the board
/P3A_P: T12.2; also elsewhere on the board
/P3B_N: T10.2; also elsewhere on the board
/P3B_P: T10.1; also elsewhere on the board
/P3C_N: T14.1; also elsewhere on the board
/P3C_P: T14.2; also elsewhere on the board
/P3D_N: T16.1; also elsewhere on the board
/P3D_P: T16.2; also elsewhere on the board
/P4A_N: T11.1; also elsewhere on the board
/P4A_P: T11.2; also elsewhere on the board
/P4B_N: T9.2; also elsewhere on the board
/P4B_P: T9.1; also elsewhere on the board
/P4C_N: T13.1; also elsewhere on the board
/P4C_P: T13.2; also elsewhere on the board
/P4D_N: T15.1; also elsewhere on the board
/P4D_P: T15.2; also elsewhere on the board
/Transformer1G/1A_N: L3.2; also elsewhere on the board
/Transformer1G/01A_N: L3.1, T3.6
/Transformer1G/1A_P: L3.3; also elsewhere on the board
/Transformer1G/01A_P: L3.4, T3.7
/Transformer1G/1B_N: L1.2; also elsewhere on the board
/Transformer1G/01B_N: L1.1, T1.6
/Transformer1G/1B_P: L1.3; also elsewhere on the board
/Transformer1G/01B_P: L1.4, T1.7
/Transformer1G/1C_N: L5.3; also elsewhere on the board
/Transformer1G/01C_N: L5.4, T5.7
/Transformer1G/1C_P: L5.2; also elsewhere on the board
/Transformer1G/01C_P: L5.1, T5.6
/Transformer1G/1D_N: L7.3; also elsewhere on the board
/Transformer1G/01D_N: L7.4, T7.7
/Transformer1G/1D_P: L7.2; also elsewhere on the board
/Transformer1G/01D_P: L7.1, T7.6
/Transformer1G/2A_N: L4.2; also elsewhere on the board
/Transformer1G/02A_N: L4.1, T4.6
/Transformer1G/2A_P: L4.3; also elsewhere on the board
/Transformer1G/02A_P: L4.4, T4.7
/Transformer1G/2B_N: L2.3; also elsewhere on the board
/Transformer1G/02B_N: L2.4, T2.7
/Transformer1G/2B_P: L2.2; also elsewhere on the board
/Transformer1G/02B_P: L2.1, T2.6
/Transformer1G/2C_N: L6.2; also elsewhere on the board
/Transformer1G/02C_N: L6.1, T6.6
/Transformer1G/2C_P: L6.3; also elsewhere on the board
/Transformer1G/02C_P: L6.4, T6.7
/Transformer1G/2D_N: L8.2; also elsewhere on the board
/Transformer1G/02D_N: L8.1, T8.6
/Transformer1G/2D_P: L8.3; also elsewhere on the board
/Transformer1G/02D_P: L8.4, T8.7
/Transformer1G/3A_N: L12.2; also elsewhere on the board
/Transformer1G/03A_N: L12.1, T12.6
/Transformer1G/3A_P: L12.3; also elsewhere on the board
/Transformer1G/03A_P: L12.4, T12.7
/Transformer1G/3B_N: L10.3; also elsewhere on the board
/Transformer1G/03B_N: L10.4, T10.7
/Transformer1G/3B_P: L10.2; also elsewhere on the board
/Transformer1G/03B_P: L10.1, T10.6
/Transformer1G/3C_N: L14.2; also elsewhere on the board
/Transformer1G/03C_N: L14.1, T14.6
/Transformer1G/3C_P: L14.3; also elsewhere on the board
/Transformer1G/03C_P: L14.4, T14.7
/Transformer1G/3D_N: L16.2; also elsewhere on the board
/Transformer1G/03D_N: L16.1, T16.6
/Transformer1G/3D_P: L16.3; also elsewhere on the board
/Transformer1G/03D_P: L16.4, T16.7
/Transformer1G/4A_N: L11.2; also elsewhere on the board
/Transformer1G/04A_N: L11.1, T11.6
/Transformer1G/4A_P: L11.3; also elsewhere on the board
/Transformer1G/04A_P: L11.4, T11.7
/Transformer1G/4B_N: L9.3; also elsewhere on the board
/Transformer1G/04B_N: L9.4, T9.7
/Transformer1G/4B_P: L9.2; also elsewhere on the board
/Transformer1G/04B_P: L9.1, T9.6
/Transformer1G/4C_N: L13.2; also elsewhere on the board
/Transformer1G/04C_N: L13.1, T13.6
/Transformer1G/4C_P: L13.3; also elsewhere on the board
/Transformer1G/04C_P: L13.4, T13.7
/Transformer1G/4D_N: L15.2; also elsewhere on the board
/Transformer1G/04D_N: L15.1, T15.6
/Transformer1G/4D_P: L15.3; also elsewhere on the board
/Transformer1G/04D_P: L15.4, T15.7
GND: C1.1, C2.1, C3.1, C4.1, C5.1, C6.1, C7.1, C8.1, C11.1, C12.1, C13.1, C14.1, C15.1, C16.1, C17.1, C18.1, C21.1, R25.1; also elsewhere on the board
GNDREF: C9.2, C10.2, C19.2, C20.2, C21.2, R25.2; also elsewhere on the board
unnamed: C1.2, T1.5
unnamed: C2.2, T2.5
unnamed: C3.2, T3.5
unnamed: C4.2, T4.5
unnamed: C5.2, T5.5
unnamed: C6.2, T6.5
unnamed: C7.2, T7.5
unnamed: C8.2, T8.5
unnamed: C9.1, R9.2, R11.2, R13.2, R15.2
unnamed: C10.1, R10.2, R12.2, R14.2, R16.2
unnamed: C11.2, T9.5
unnamed: C12.2, T10.5
unnamed: C13.2, T11.5
unnamed: C14.2, T12.5
unnamed: C15.2, T13.5
unnamed: C16.2, T14.5
unnamed: C17.2, T15.5
unnamed: C18.2, T16.5
unnamed: C19.1, R17.2, R19.2, R21.2, R23.2
unnamed: C20.1, R18.2, R20.2, R22.2, R24.2
unnamed: R9.1, T1.3, T1.4
unnamed: R10.1, T2.3, T2.4
unnamed: R11.1, T3.3, T3.4
unnamed: R12.1, T4.3, T4.4
unnamed: R13.1, T5.3, T5.4
unnamed: R14.1, T6.3, T6.4
unnamed: R15.1, T7.3, T7.4
unnamed: R16.1, T8.3, T8.4
unnamed: R17.1, T9.3, T9.4
unnamed: R18.1, T10.3, T10.4
unnamed: R19.1, T11.3, T11.4
unnamed: R20.1, T12.3, T12.4
unnamed: R21.1, T13.3, T13.4
unnamed: R22.1, T14.3, T14.4
unnamed: R23.1, T15.3, T15.4
unnamed: R24.1, T16.3, T16.4

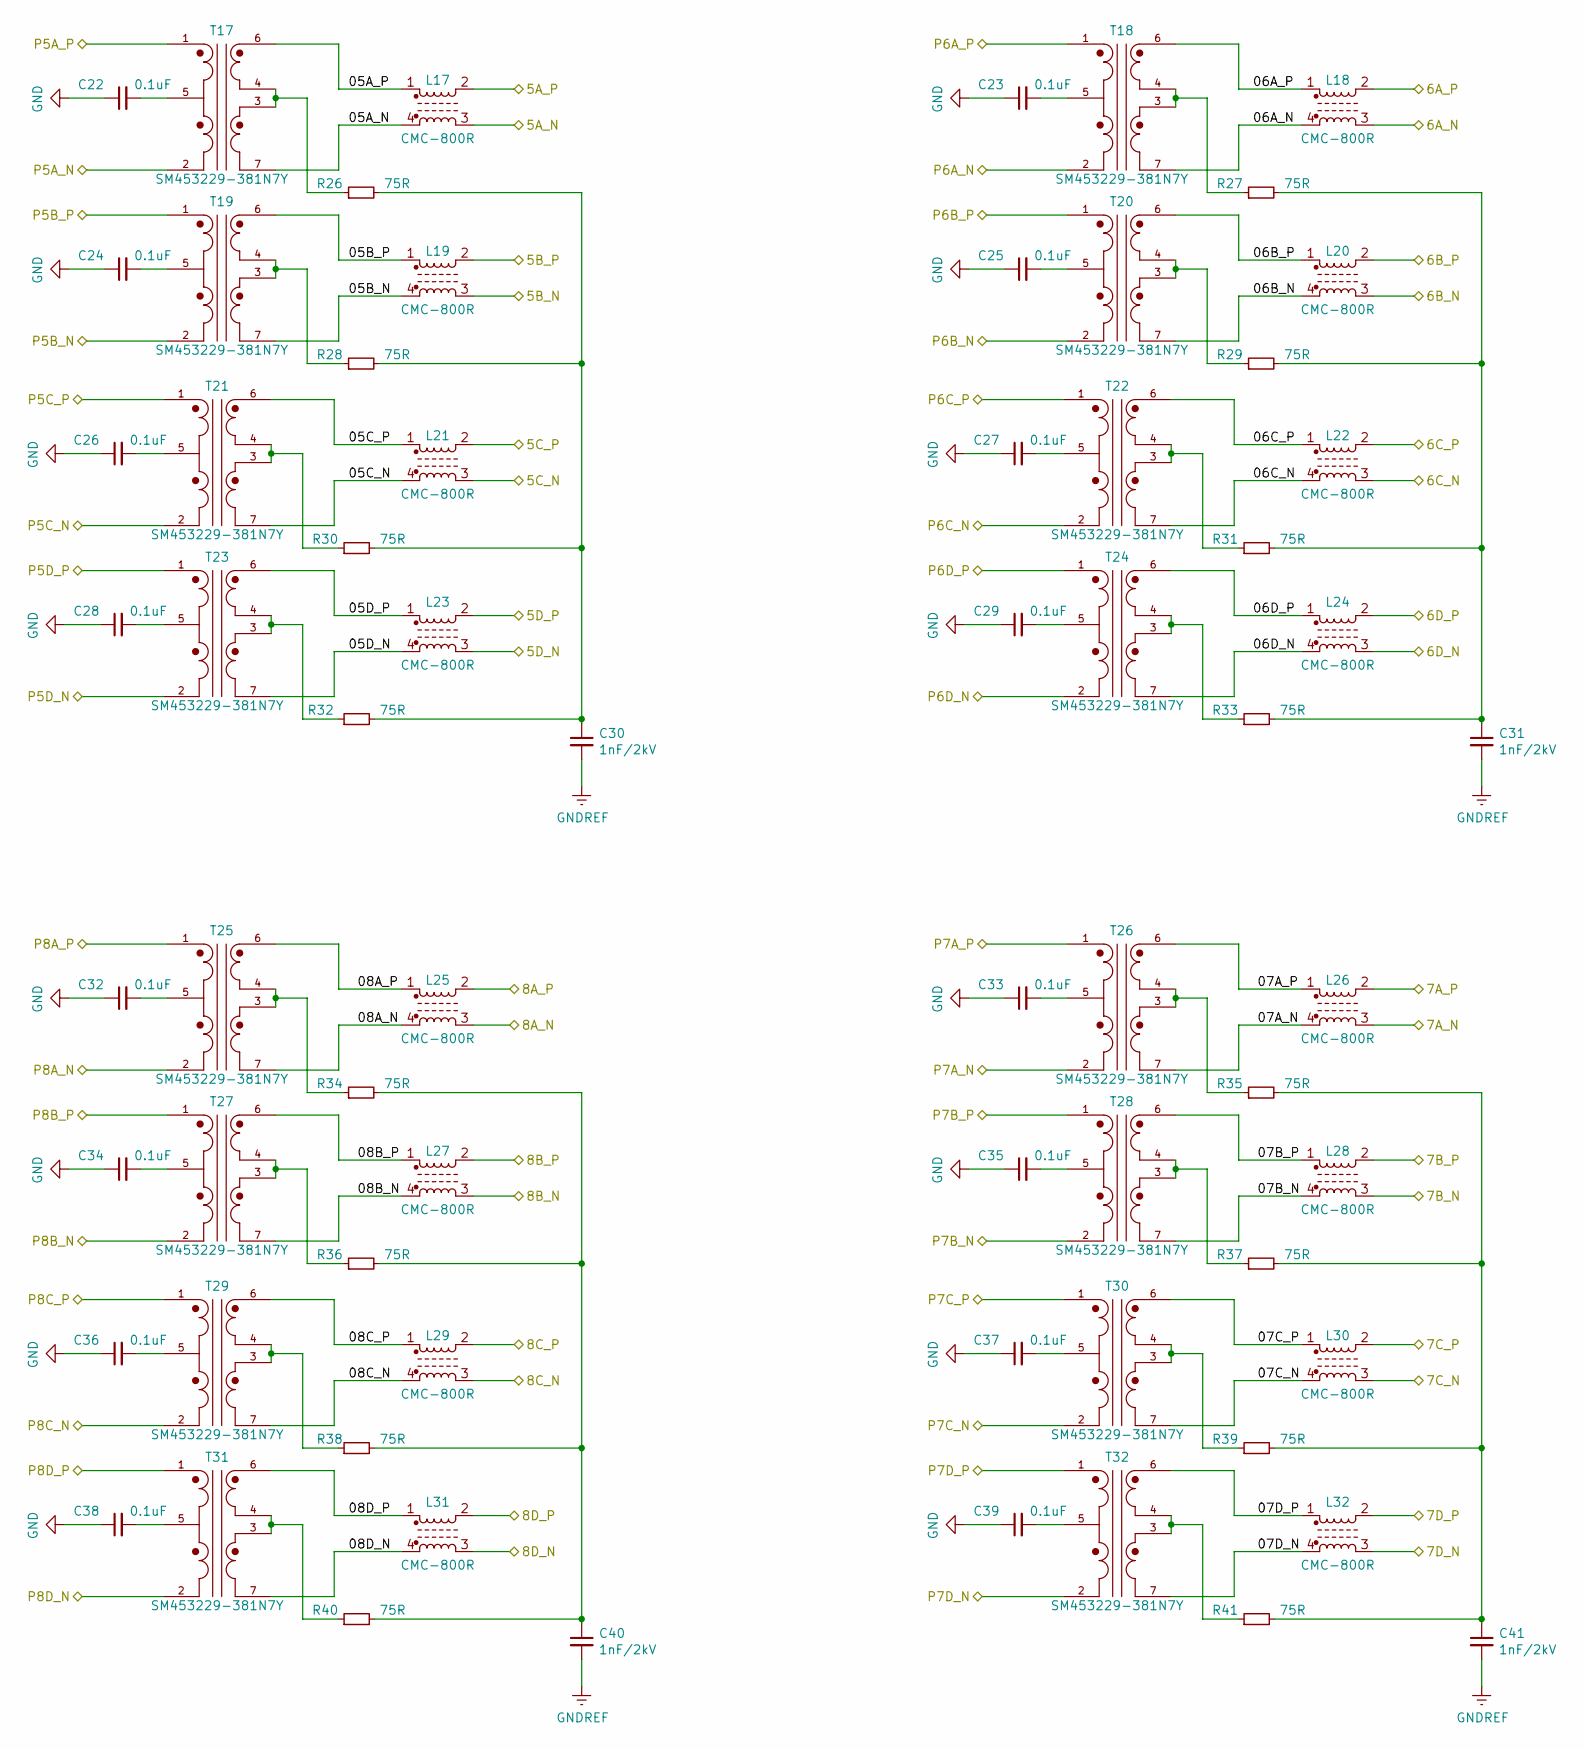
[picture p15: schematic Transformer1G_P5678.kicad_sch, UbiConn]

Parts:
C22, C23, C24, C25, C26, C27, C28, C29, C32, C33, C34, C35, C36, C37, C38, C39: 0.1uF; C_0402_Small; Voltage Rating 50V; MPN GRM155R71H104KE14J; LCSC# C85858
C30, C31, C40, C41: 1nF/2kV; C_1206_3216Metric; Voltage Rating 2KV; MPN CC1206KKX7RDBB102; LCSC# C23631
L17, L18, L19, L20, L21, L22, L23, L24, L25, L26, L27, L28, L29, L30, L31, L32: CMC-800R; SRF2012A-801Y; MPN CND-WCM0805M801-2; LCSC# C3020807
R26, R27, R28, R29, R30, R31, R32, R33, R34, R35, R36, R37, R38, R39, R40, R41: 75R; R_0402_1005Metric; Tolerance 1%; MPN RC0402FR-0775RL; LCSC# C114757
T17, T18, T19, T20, T21, T22, T23, T24, T25, T26, T27, T28, T29, T30, T31, T32: SM453229-381N7Y; SM453229-381N7Y_thinner; MPN SM453229-381N7Y; LCSC# C913239

Connections:
/P5A_N: T17.2; also elsewhere on the board
/P5A_P: T17.1; also elsewhere on the board
/P5B_N: T19.2; also elsewhere on the board
/P5B_P: T19.1; also elsewhere on the board
/P5C_N: T21.2; also elsewhere on the board
/P5C_P: T21.1; also elsewhere on the board
/P5D_N: T23.2; also elsewhere on the board
/P5D_P: T23.1; also elsewhere on the board
/P6A_N: T18.2; also elsewhere on the board
/P6A_P: T18.1; also elsewhere on the board
/P6B_N: T20.2; also elsewhere on the board
/P6B_P: T20.1; also elsewhere on the board
/P6C_N: T22.2; also elsewhere on the board
/P6C_P: T22.1; also elsewhere on the board
/P6D_N: T24.2; also elsewhere on the board
/P6D_P: T24.1; also elsewhere on the board
/P7A_N: T26.2; also elsewhere on the board
/P7A_P: T26.1; also elsewhere on the board
/P7B_N: T28.2; also elsewhere on the board
/P7B_P: T28.1; also elsewhere on the board
/P7C_N: T30.2; also elsewhere on the board
/P7C_P: T30.1; also elsewhere on the board
/P7D_N: T32.2; also elsewhere on the board
/P7D_P: T32.1; also elsewhere on the board
/P8A_N: T25.2; also elsewhere on the board
/P8A_P: T25.1; also elsewhere on the board
/P8B_N: T27.2; also elsewhere on the board
/P8B_P: T27.1; also elsewhere on the board
/P8C_N: T29.2; also elsewhere on the board
/P8C_P: T29.1; also elsewhere on the board
/P8D_N: T31.2; also elsewhere on the board
/P8D_P: T31.1; also elsewhere on the board
/Transformer1G_P5678/5A_N: L17.3; also elsewhere on the board
/Transformer1G_P5678/05A_N: L17.4, T17.7
/Transformer1G_P5678/5A_P: L17.2; also elsewhere on the board
/Transformer1G_P5678/05A_P: L17.1, T17.6
/Transformer1G_P5678/5B_N: L19.3; also elsewhere on the board
/Transformer1G_P5678/05B_N: L19.4, T19.7
/Transformer1G_P5678/5B_P: L19.2; also elsewhere on the board
/Transformer1G_P5678/05B_P: L19.1, T19.6
/Transformer1G_P5678/5C_N: L21.3; also elsewhere on the board
/Transformer1G_P5678/05C_N: L21.4, T21.7
/Transformer1G_P5678/5C_P: L21.2; also elsewhere on the board
/Transformer1G_P5678/05C_P: L21.1, T21.6
/Transformer1G_P5678/5D_N: L23.3; also elsewhere on the board
/Transformer1G_P5678/05D_N: L23.4, T23.7
/Transformer1G_P5678/5D_P: L23.2; also elsewhere on the board
/Transformer1G_P5678/05D_P: L23.1, T23.6
/Transformer1G_P5678/6A_N: L18.3; also elsewhere on the board
/Transformer1G_P5678/06A_N: L18.4, T18.7
/Transformer1G_P5678/6A_P: L18.2; also elsewhere on the board
/Transformer1G_P5678/06A_P: L18.1, T18.6
/Transformer1G_P5678/6B_N: L20.3; also elsewhere on the board
/Transformer1G_P5678/06B_N: L20.4, T20.7
/Transformer1G_P5678/6B_P: L20.2; also elsewhere on the board
/Transformer1G_P5678/06B_P: L20.1, T20.6
/Transformer1G_P5678/6C_N: L22.3; also elsewhere on the board
/Transformer1G_P5678/06C_N: L22.4, T22.7
/Transformer1G_P5678/6C_P: L22.2; also elsewhere on the board
/Transformer1G_P5678/06C_P: L22.1, T22.6
/Transformer1G_P5678/6D_N: L24.3; also elsewhere on the board
/Transformer1G_P5678/06D_N: L24.4, T24.7
/Transformer1G_P5678/6D_P: L24.2; also elsewhere on the board
/Transformer1G_P5678/06D_P: L24.1, T24.6
/Transformer1G_P5678/7A_N: L26.3; also elsewhere on the board
/Transformer1G_P5678/07A_N: L26.4, T26.7
/Transformer1G_P5678/7A_P: L26.2; also elsewhere on the board
/Transformer1G_P5678/07A_P: L26.1, T26.6
/Transformer1G_P5678/7B_N: L28.3; also elsewhere on the board
/Transformer1G_P5678/07B_N: L28.4, T28.7
/Transformer1G_P5678/7B_P: L28.2; also elsewhere on the board
/Transformer1G_P5678/07B_P: L28.1, T28.6
/Transformer1G_P5678/7C_N: L30.3; also elsewhere on the board
/Transformer1G_P5678/07C_N: L30.4, T30.7
/Transformer1G_P5678/7C_P: L30.2; also elsewhere on the board
/Transformer1G_P5678/07C_P: L30.1, T30.6
/Transformer1G_P5678/7D_N: L32.3; also elsewhere on the board
/Transformer1G_P5678/07D_N: L32.4, T32.7
/Transformer1G_P5678/7D_P: L32.2; also elsewhere on the board
/Transformer1G_P5678/07D_P: L32.1, T32.6
/Transformer1G_P5678/8A_N: L25.3; also elsewhere on the board
/Transformer1G_P5678/08A_N: L25.4, T25.7
/Transformer1G_P5678/8A_P: L25.2; also elsewhere on the board
/Transformer1G_P5678/08A_P: L25.1, T25.6
/Transformer1G_P5678/8B_N: L27.3; also elsewhere on the board
/Transformer1G_P5678/08B_N: L27.4, T27.7
/Transformer1G_P5678/8B_P: L27.2; also elsewhere on the board
/Transformer1G_P5678/08B_P: L27.1, T27.6
/Transformer1G_P5678/8C_N: L29.3; also elsewhere on the board
/Transformer1G_P5678/08C_N: L29.4, T29.7
/Transformer1G_P5678/8C_P: L29.2; also elsewhere on the board
/Transformer1G_P5678/08C_P: L29.1, T29.6
/Transformer1G_P5678/8D_N: L31.3; also elsewhere on the board
/Transformer1G_P5678/08D_N: L31.4, T31.7
/Transformer1G_P5678/8D_P: L31.2; also elsewhere on the board
/Transformer1G_P5678/08D_P: L31.1, T31.6
GND: C22.1, C23.1, C24.1, C25.1, C26.1, C27.1, C28.1, C29.1, C32.1, C33.1, C34.1, C35.1, C36.1, C37.1, C38.1, C39.1; also elsewhere on the board
GNDREF: C30.2, C31.2, C40.2, C41.2; also elsewhere on the board
unnamed: C22.2, T17.5
unnamed: C23.2, T18.5
unnamed: C24.2, T19.5
unnamed: C25.2, T20.5
unnamed: C26.2, T21.5
unnamed: C27.2, T22.5
unnamed: C28.2, T23.5
unnamed: C29.2, T24.5
unnamed: C30.1, R26.2, R28.2, R30.2, R32.2
unnamed: C31.1, R27.2, R29.2, R31.2, R33.2
unnamed: C32.2, T25.5
unnamed: C33.2, T26.5
unnamed: C34.2, T27.5
unnamed: C35.2, T28.5
unnamed: C36.2, T29.5
unnamed: C37.2, T30.5
unnamed: C38.2, T31.5
unnamed: C39.2, T32.5
unnamed: C40.1, R34.2, R36.2, R38.2, R40.2
unnamed: C41.1, R35.2, R37.2, R39.2, R41.2
unnamed: R26.1, T17.3, T17.4
unnamed: R27.1, T18.3, T18.4
unnamed: R28.1, T19.3, T19.4
unnamed: R29.1, T20.3, T20.4
unnamed: R30.1, T21.3, T21.4
unnamed: R31.1, T22.3, T22.4
unnamed: R32.1, T23.3, T23.4
unnamed: R33.1, T24.3, T24.4
unnamed: R34.1, T25.3, T25.4
unnamed: R35.1, T26.3, T26.4
unnamed: R36.1, T27.3, T27.4
unnamed: R37.1, T28.3, T28.4
unnamed: R38.1, T29.3, T29.4
unnamed: R39.1, T30.3, T30.4
unnamed: R40.1, T31.3, T31.4
unnamed: R41.1, T32.3, T32.4

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
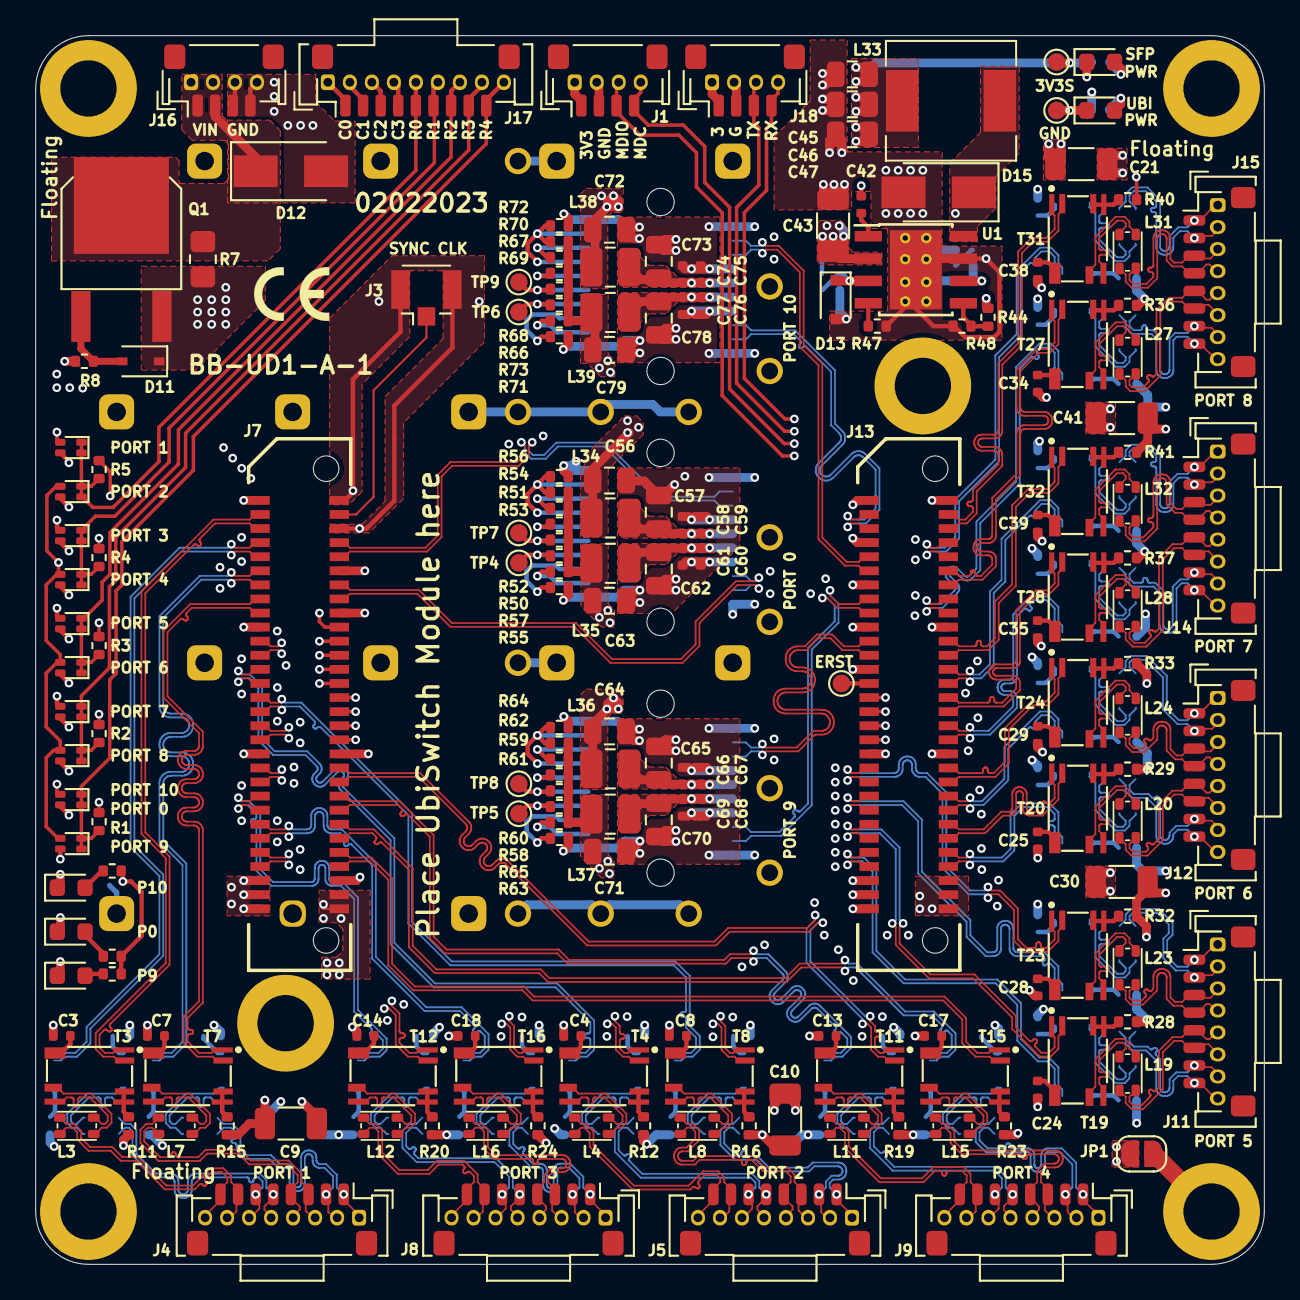
[picture p16: board UbiConnRevA.kicad_pcb from above]

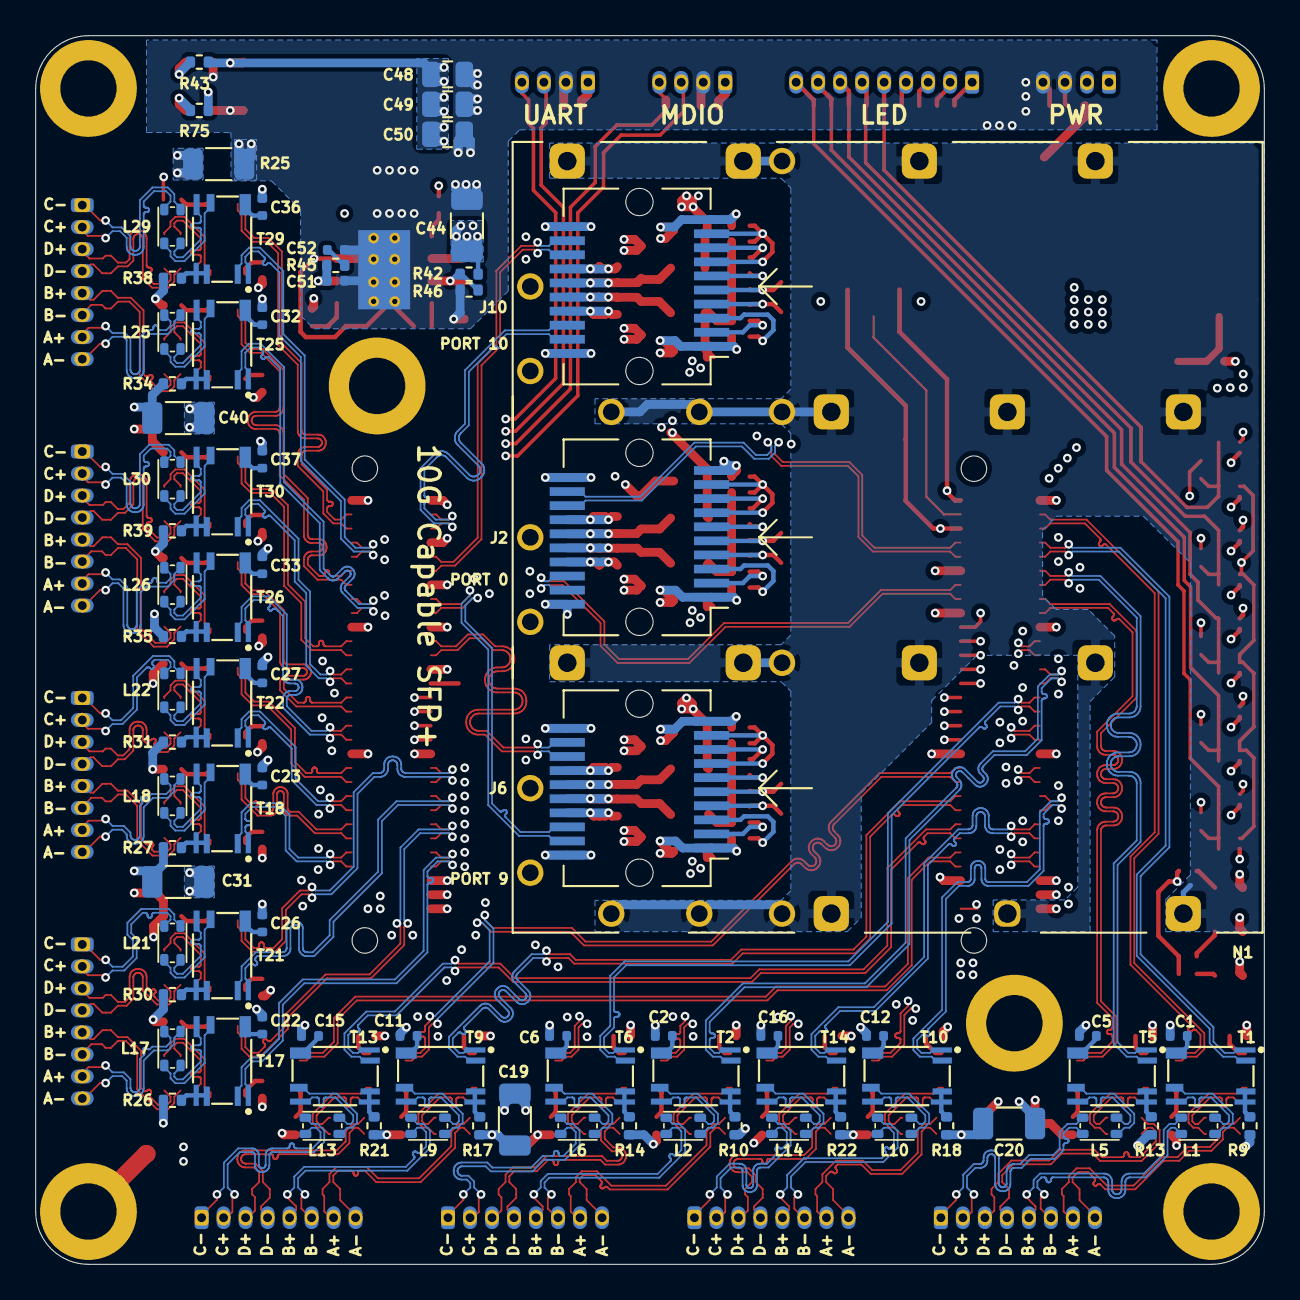
[picture p17: board UbiConnRevA.kicad_pcb from below]

Board: 6 copper layers, 69.8 x 69.8 mm, 279 parts (84 on the bottom side), 343 nets.
